CodeStix/Home-Control-GIP/Documentatie/Dossier/Fotos/IMG_4133.JPG

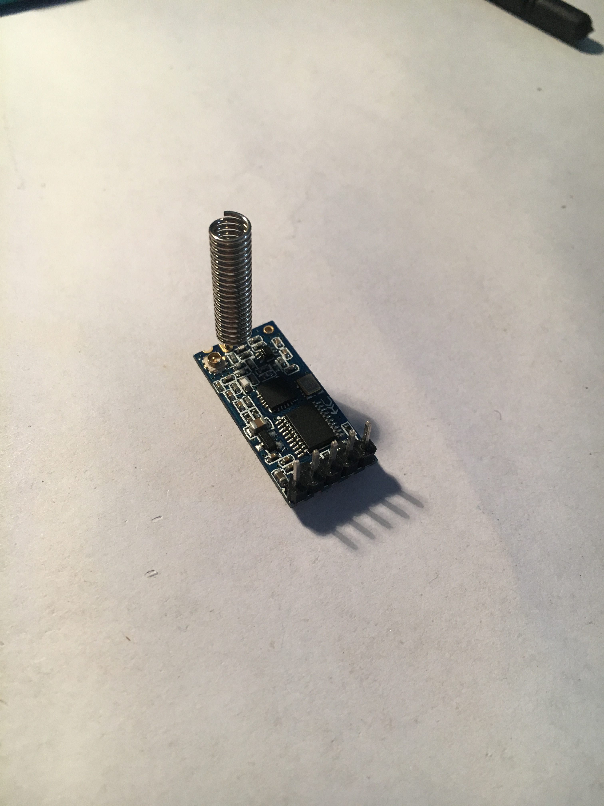
Documentatie/Dossier/Fotos/IMG_4133.JPG
