CodeStix/Home-Control-GIP/Documentatie/Dossier/Fotos/IMG_4117.JPG

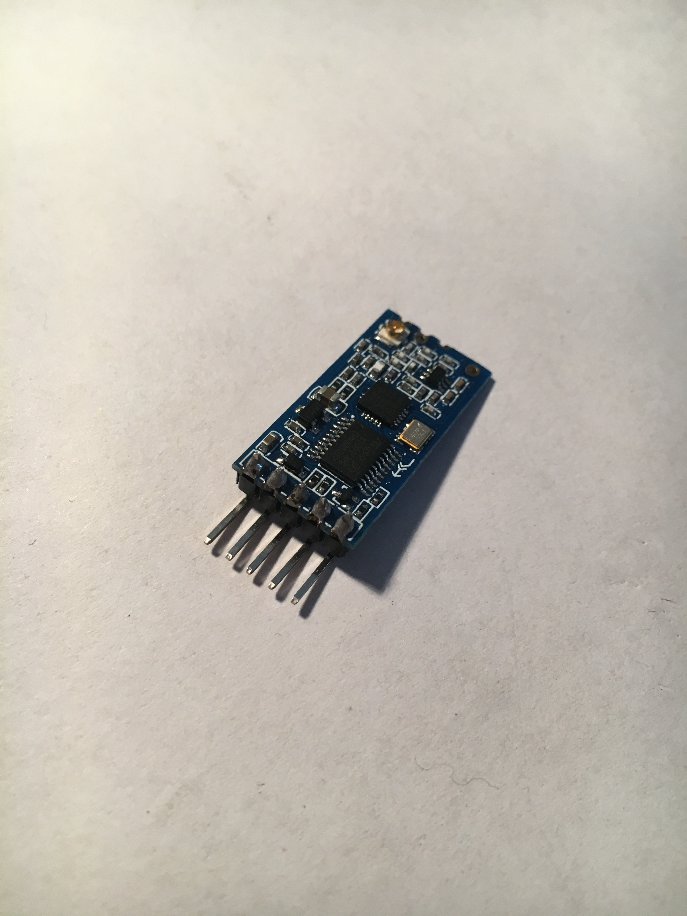
Documentatie/Dossier/Fotos/IMG_4117.JPG
