CodeStix/Home-Control-GIP/README.md

# Geïntegreerde proef: Home Control

Dit is een repo over mijn eindwerk voor de richting 6 elektriciteit-elektronica. Hier bevinden zich alle scripts, presentaties, schema's, documentaties ...

In het kort: een draadloos home-control systeem waarbij je eenvoudig en snel huishoudelijke apparaten kan aansturen via een gebruiksvriendelijke smartphone app zonder jezelf vragen te stellen over privacy.

Zie documentatie voor uitgebreide informatie.
