CodeStix/Home-Control-GIP/Slaves.rtf

## Slaves

UFID
USE
TYPE
LIVE_DATA

# Types

[0] = Aantal knoppen
[1] = Aantal drukknoppen
[2] = Aantal sliders
[2] = 3: RGB sliders
[2] = 5: RGB sliders + effect/speed slider

# 1 (5 volt module, anderen zijn 3.3 volt)

EE 0 0 0 0 0 0
Addressable ledstrip
0 0 5 0
Niks

# 2

EE 1 0 0 0 0 0
Ledstrip
0 0 3 0
Stroom

# 3

EE 2 0 0 0 0 0
Relay module 8: Disco lamp & Ventilator (want 12 volt)
8 0 0 0
Stroom? Temperatuur?

# 4

EE 3 0 0 0 0 0
Relay module 8: 2 Lampjes (want 5 volt)
8 0 0 0
Niks

# 5

EE 4 0 0 0 0 0
Led matrix
0 0 1 0
Niks

# 6

EE 5 0 0 0 0 0
