CodeStix/Home-Control-GIP/Schemas/Belasting.docx

Belasting | Bij 1 A | Bij 2 A
500 Ω | 1.44 V | 2.82 V
1k Ω | 2.75 V | 5.38 V
2k Ω | 5.47 V | 10.13 V
