CodeStix/Home-Control-GIP/Documentatie/GIP Stijn Dylan 6EE 1.pptx

## Smart Home

Stijn Rogiest & Dylan Dedapper

## Doel

- Verbeteren & versimpelen
- Universeel
- Weinig interferenties
- Goedkoop

## WAT

- makkelijk toegankelijk, snel en goed werkend systeem
- automatisatie van bvb: lichten, huishoudapparaten,verwarming…
- bediend met app of UI (user interface)

## Hardware

- "Main Control Unit" of afgekort (H-MCU)
- "Controlled Unit" of afgekort (H-CU)
- "Controlled Resource Unit" of afgekort (H-CRU)

## H-MCU

- Hoofd controller (master)
- Bestaat uit : micro controller en radio module
- stuurt naar de andere units en regelt alles

## H-CU

- Gewone controller (slave)
- Bestaat uit : micro controller en radio module
- Stuurt externe elektronica aan op bevel van de H-CMU bvb: lichten, magnetisch slot,rolluiken ...

## H-CRU

- Controller met monitoring (slave)
- Bestaat uit : micro controller en radio module
- stuurt elektronica aan die monitoring nodig heeft bvb: verwarming, ventilatie, weerstation ...

## Software

- App voor aansturing en overzicht apparaten
- Protocol genaamd HCP
- Encryptie voor beveiliging genaamd LSE

## Protocol Encryptie

- Programma dat zorgt voor communicatie tussen units

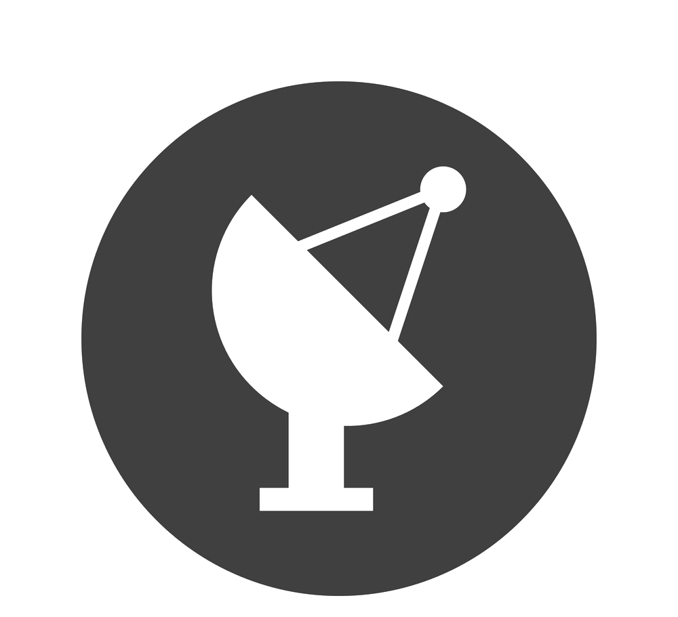
[picture p62: figure]

- Programma dat zorgt voor beveiliging en privacy

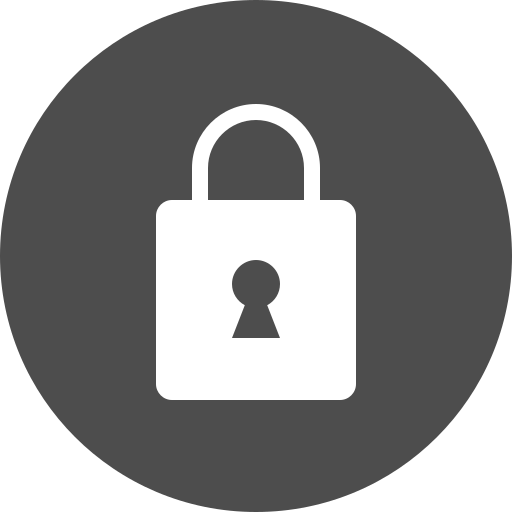
[picture p63: figure]

## Optioneel

- Protocol universaliseren
- Siri / Alexa integration
- Thuiskom-detectie(thuiskomen => lichten gaan aan)
- Automatische verwarming met tijdschema

## Slide 11

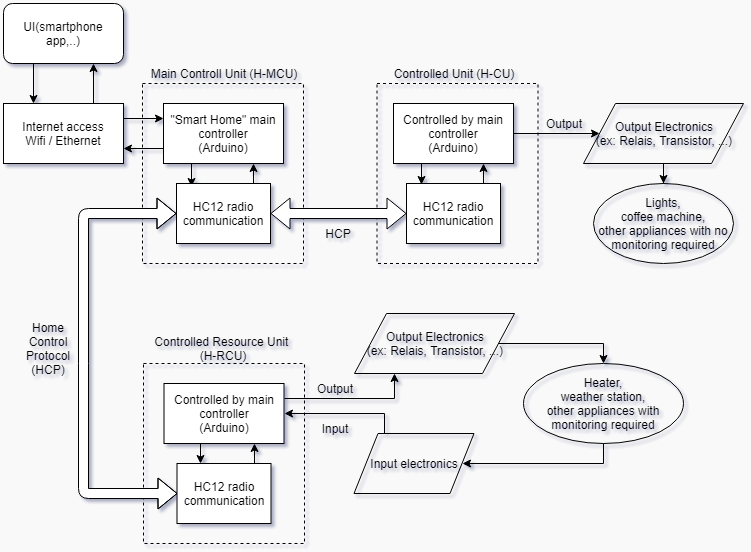
[picture p64: figure]

## EINDE
