CodeStix/Home-Control-GIP/Documentatie/GIP Stijn Dylan 6EE 2.pptx

## Smart Home Systeem

Stijn Rogiest
Dylan Dedapper

## Inleiding

Wat houd onze GIP praktisch in?

## 1.1 Onderwerp

Ons onderwerp in tien woorden samengevat.

“Goedkoop en zelfstandig het huis automatiseren via verschillende voorgeprogrammeerde modules.”

## 1.2 De Planning

Wat moet er nog gebeuren?

- App maken
- Voor behuizing zorgen
- Schema afmaken
- PCBs laten maken?

## 1.3 Milestones

- Goed functionerende antennes
  - Stabiele seriële communicatie
- Hardware
  - PCB
    - Master
    - Slave
- Software
  - Mobiele app
    - Communicatie naar master via HTTP
  - Protocol integreren in master & slave.
- Het Protocol (HCP)
  - Beveiligen
    - LSE
  - Feedback realiseren
  - Failover
    - Resending
    - Data loss

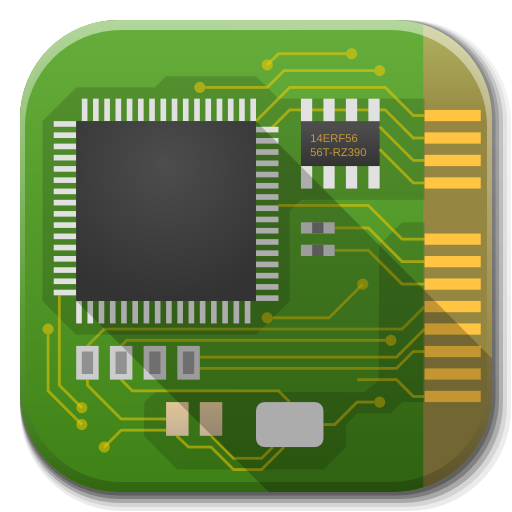
[picture p65: figure]

## 2. Realisaties

Wat is er gerealiseerd en wat moet er nog gerealiseerd worden?

## Slide 7

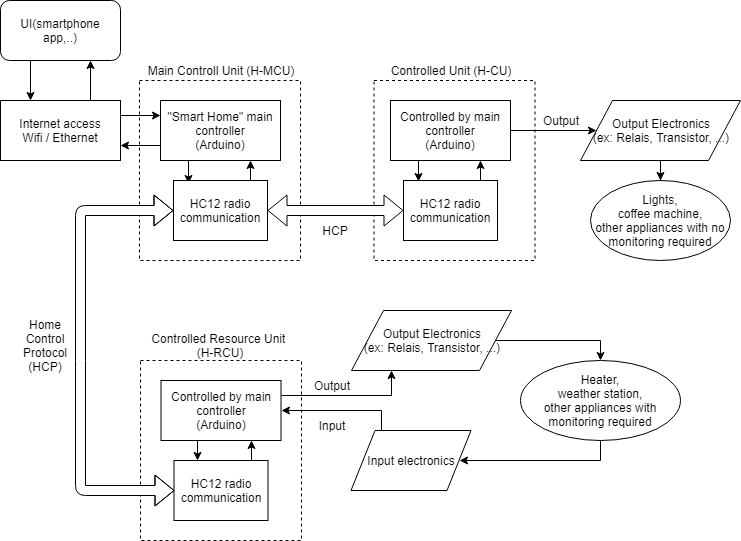
[picture p66: figure]

Notes: Tot nu toe...

## 2.1.1 Hardware

- Werking binnen het geheel.
  - Ons idee is omgezet in realiteit.
- De interactie met de software.
  - Commando’s versturen via seriële monitor.
- Draadloze communicatie
  - Zender
  - Ontvanger

Wat werk?
Wat werkt niet? En waarom?
Oplossingen?
Verbeteringen?

## Slide 9

Master

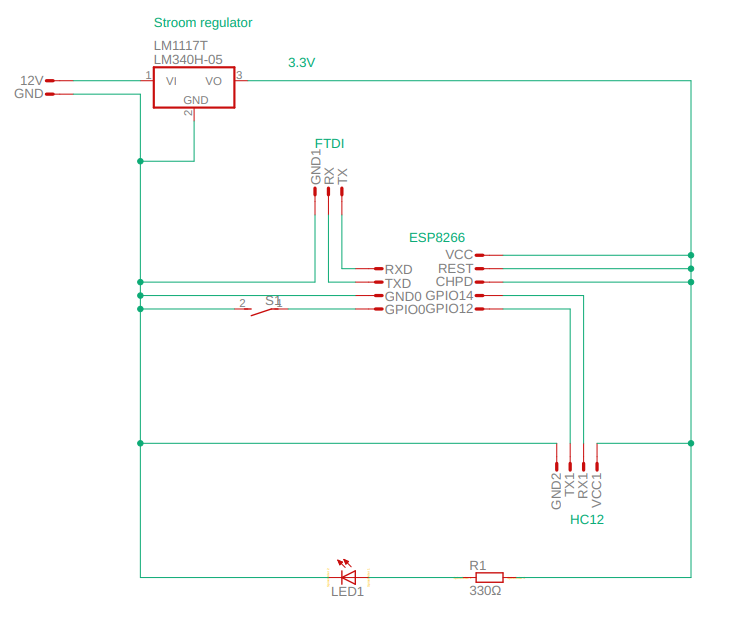
[picture p67: figure]

## Slide 10

Slave

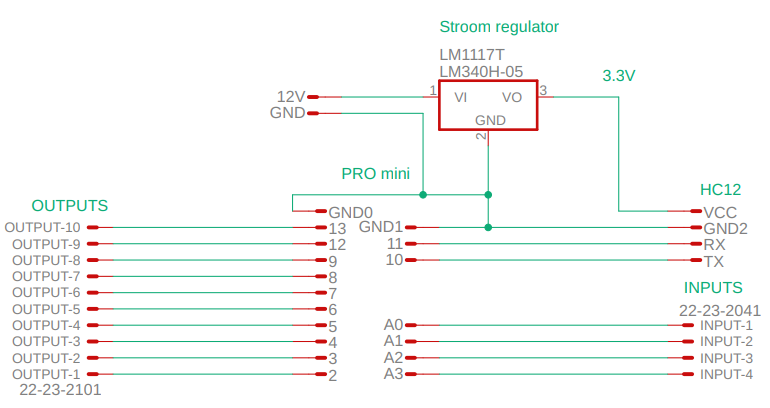
[picture p68: figure]

## 2.1.2 Software

- Een gepersonaliseerde C++ library
  - Protocol (HCP)
  - Realiseert het verstuur en ontvang gebeurden.
- Software is gemaakt
  - Gebruik gemaakt van de Arduino omgeving.
  - Library gemaakt met Visual Code
- Debuggen
  - Gebruik maken van seriële monitor.
    - Draadloze communicatie gebeurt via SoftwareSerial.

Wat werk?
Wat werkt niet? En waarom?
Oplossingen?
Verbeteringen?

## 2.1.2.1 Draadloze communicatie

Uitleg van het Protocol

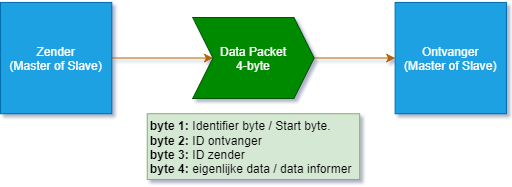
[picture p69: figure]

## Slide 13

## Slide 14

## Slide 15

## Slide 16

## Slide 17

## Slide 18

## Slide 19

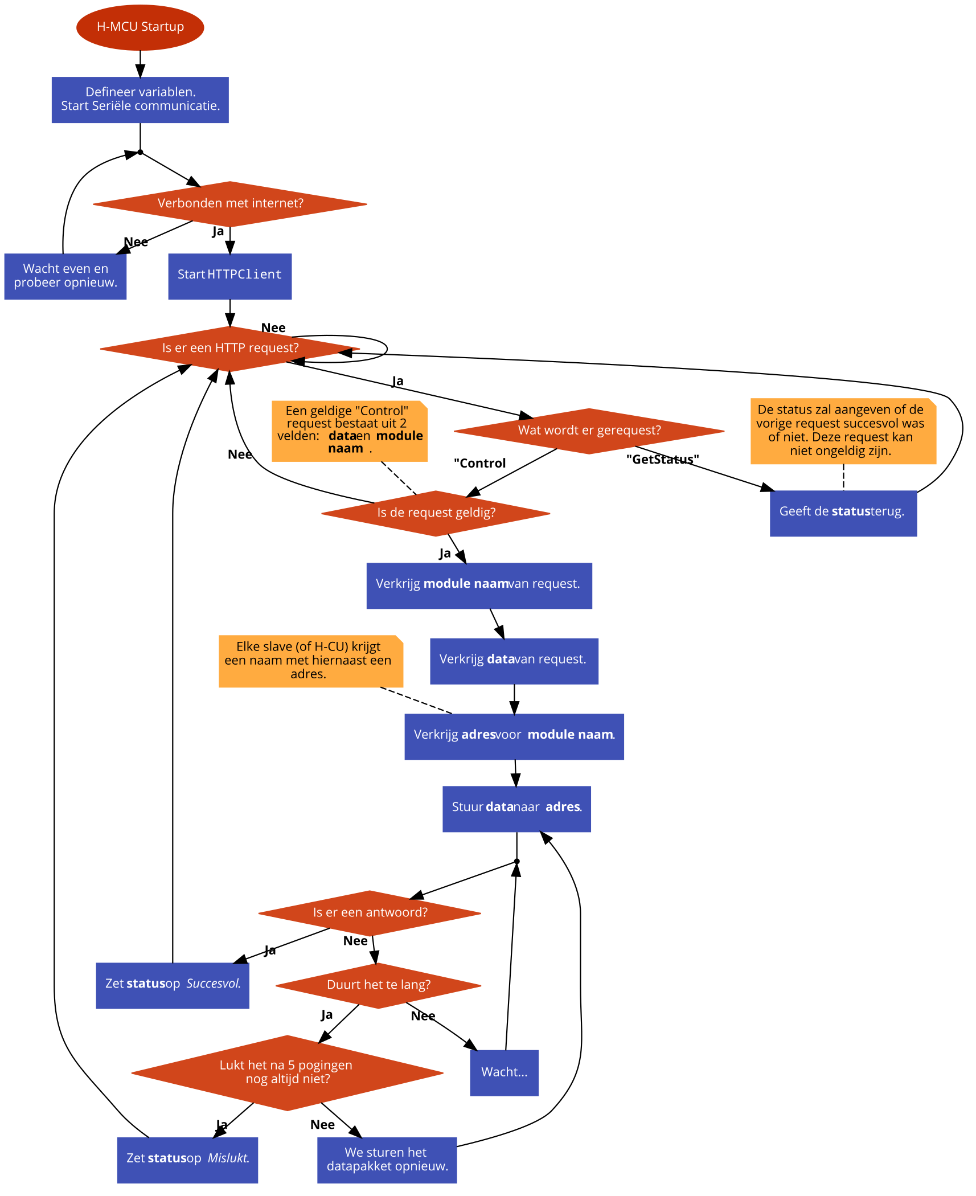
[picture p70: figure]

## Slide 20

## Slide 21

## 2.2 Wat moet er nog gerealiseerd worden?

## 2.2.1 Hardware

- Modules afwerken
  - Behuizing
  - PCB ontwerpen
  - Deftige antenne
  - Stroomdetectie

## 2.2.2 Software

- Beveiliging
  - LSE
    - Low Size Encryption
    - Op basis van 4 bytes, zie protocol.
- Stroomdetectie
  - Omvormen van waardes
- App
  - Software: Xamarin
- Gegevens naar het web
  - Versturen
  - Ontvangen

## 2.2.2.1 Alternativen

- Voor software
  - App maken via mit-builder
  - Geen LSE
- Voor hardware:
  - Spiraal antenne gebruiken
  - Geen zelfgemaakt PCB naar breadboard

## 3. Conclusies

Wat hebben we geleerd en
wat gaan we nu doen

## 3.1 Wat hebben we geleerd?

- Gebruiken van verschillende micro controllers.
- Extra aandacht geven aan goed verbinden van kabels en storing te vermijden.
- Manueel uploaden naar een micro controllers .
- Leren gebruik maken van draadloze communicatie tussen microcontrollers

## 3.2. Wat nu verder?

- Draadloze communicatie verbeteren.
- Programma optimaliseren.
- Prototype uitwerken.
- App maken.

## EINDE
