CodeStix/Home-Control-GIP/Documentatie/Logboeken/Weken/Logboek Week 22.docx

# Logboek

## Geïntegreerde Proef

Klas : 6EE

2018-2019

### Technisch adviseur coördinator : M. Van Gucht

Mentor(en) school : E. Arckens

Leerling : Stijn Rogiest

# Logboek

## Geïntegreerde Proef

Week 22

2018-2019

Naam : Home Control; H-C

Omschrijving opdracht G.I.P:

Home control systeem, een slim huis.

Betrokken leerkrachten Vak

Mr. E. Arckens Elektriciteit-elektronica

Coppejans Stijn

Schoolweek : 22

Datum | Vak | Omschrijving van de studie, taak of voorbereiding
27/05/2019 | EE | Bespreken met Dylan over het demo-huis: in dit huis zullen onze modules worden voorgesteld aan het publiek.
28/05/2019 | EE | Kritisch Thunkable probleem wegens hernamen van variabel, zo snel mogelijk een oplossing proberen vinden...
30/05/2019 | Thuis | Hermaken van de app. onoplosbaar probleem door het Thunkable platform.
31/05/2019 | Thuis | Hermaken van de app…
