CodeStix/Home-Control-GIP/App/AchtergrondKabel14.png

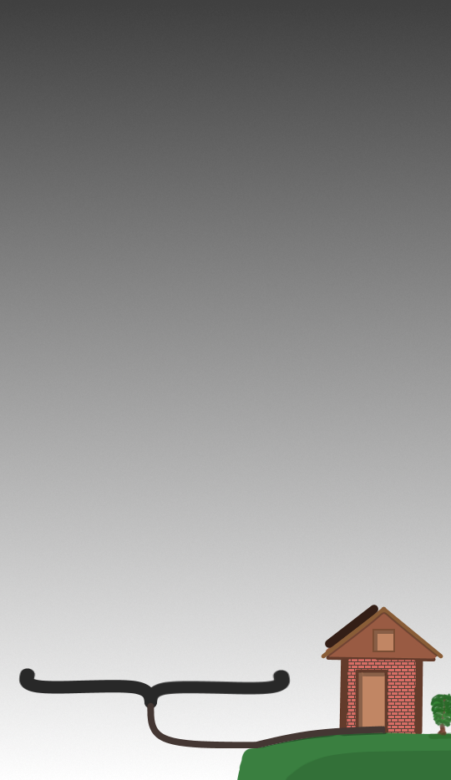
App/AchtergrondKabel14.png
