CodeStix/Home-Control-GIP/App/AchtergrondKabelWifi13.png

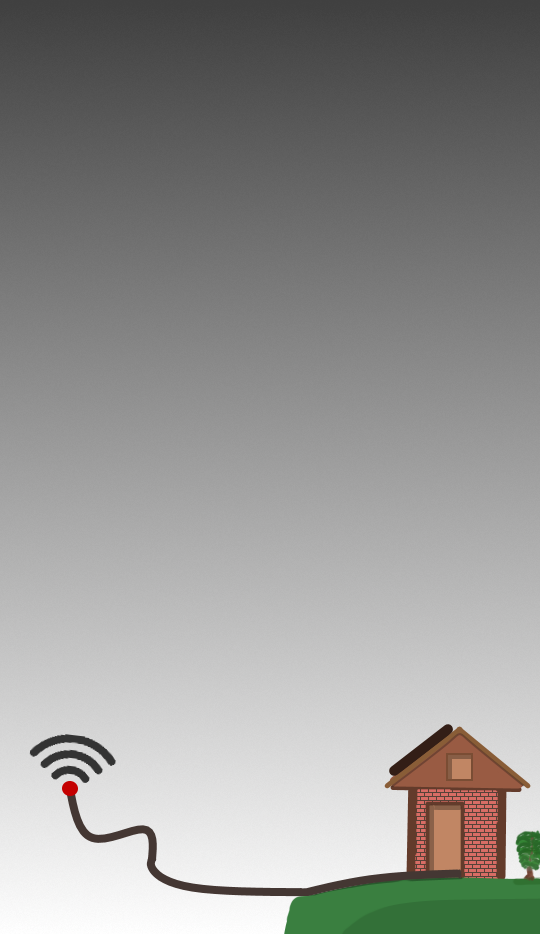
App/AchtergrondKabelWifi13.png
