CodeStix/Home-Control-GIP/App/Screenshots/Bind master.PNG

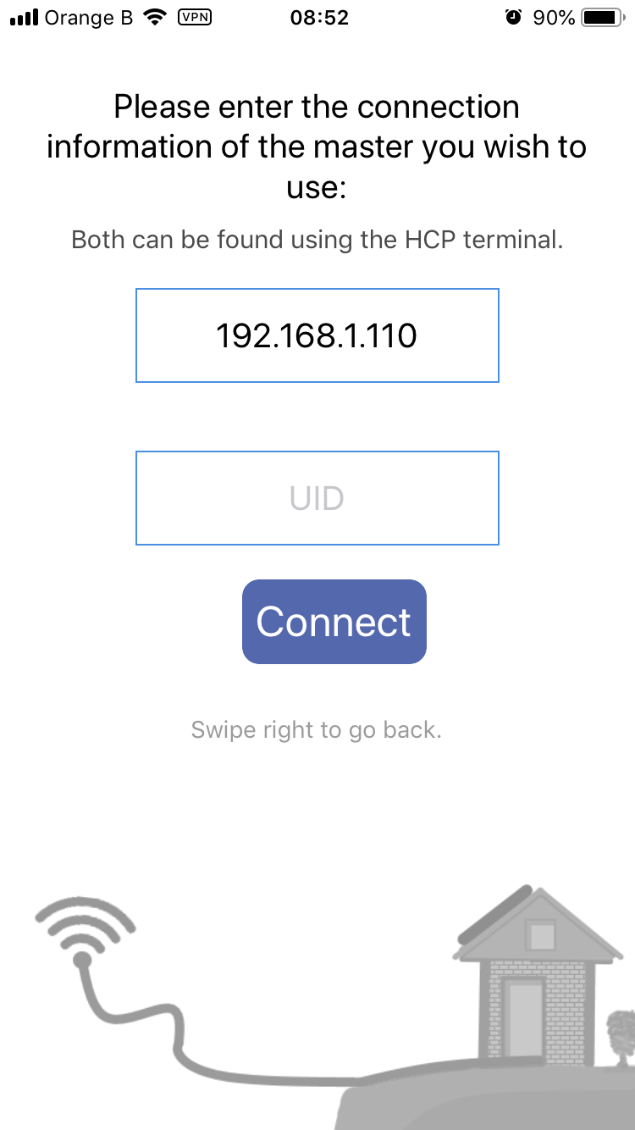
App/Screenshots/Bind master.PNG
