CodeStix/Home-Control-GIP/App/Screenshots/Configure.PNG

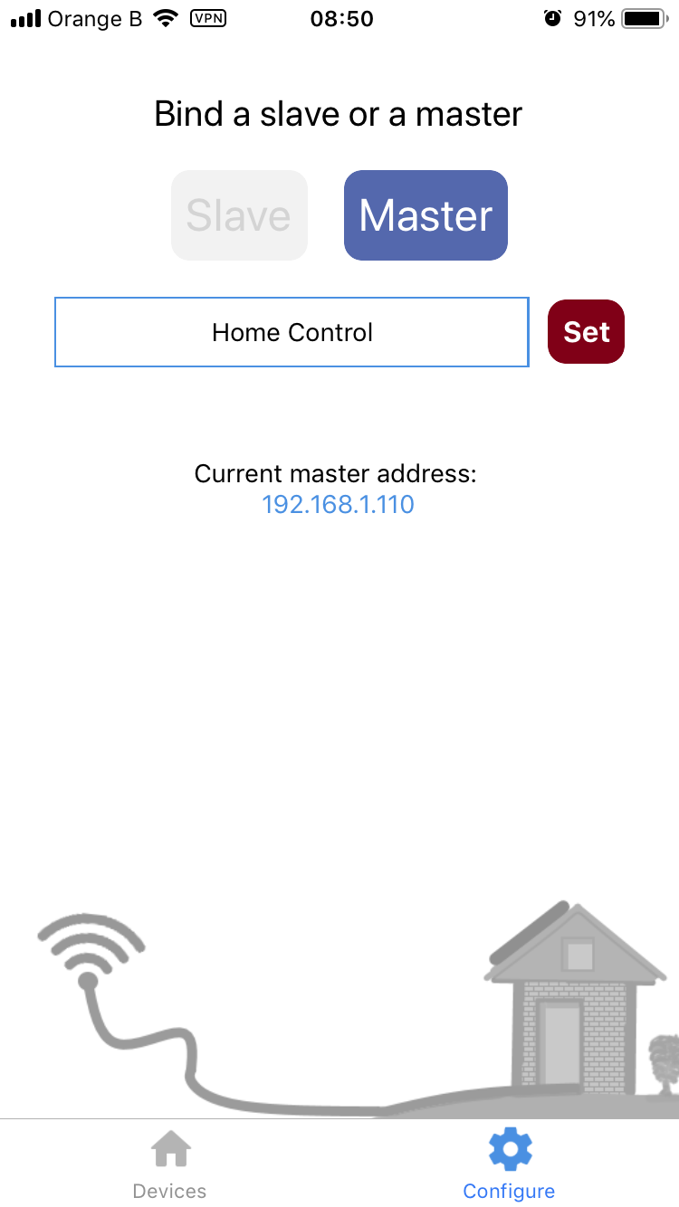
App/Screenshots/Configure.PNG
