CodeStix/Home-Control-GIP/App/Screenshots/Connection Check.PNG

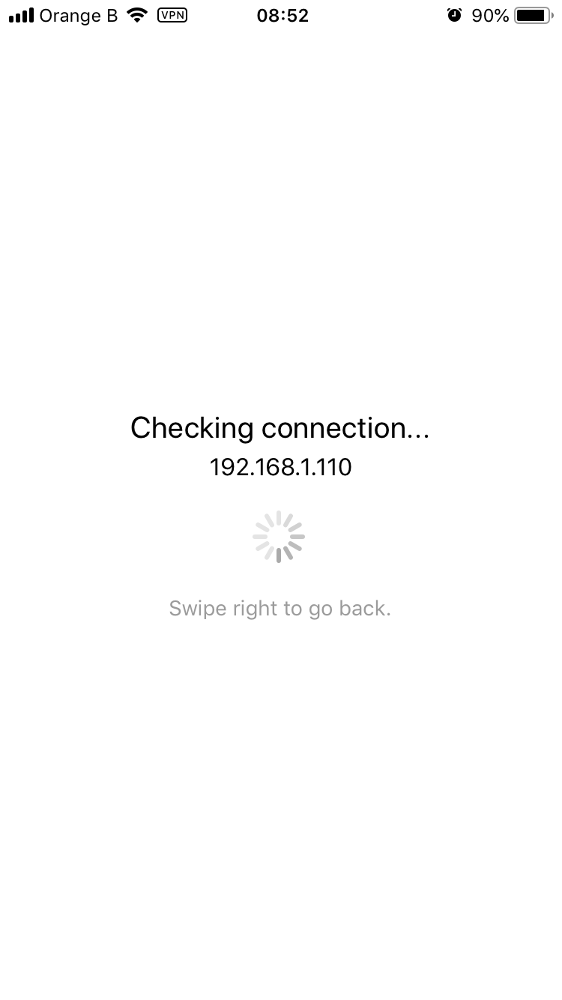
App/Screenshots/Connection Check.PNG
