CodeStix/Home-Control-GIP/App/Screenshots/Connection Fail.PNG

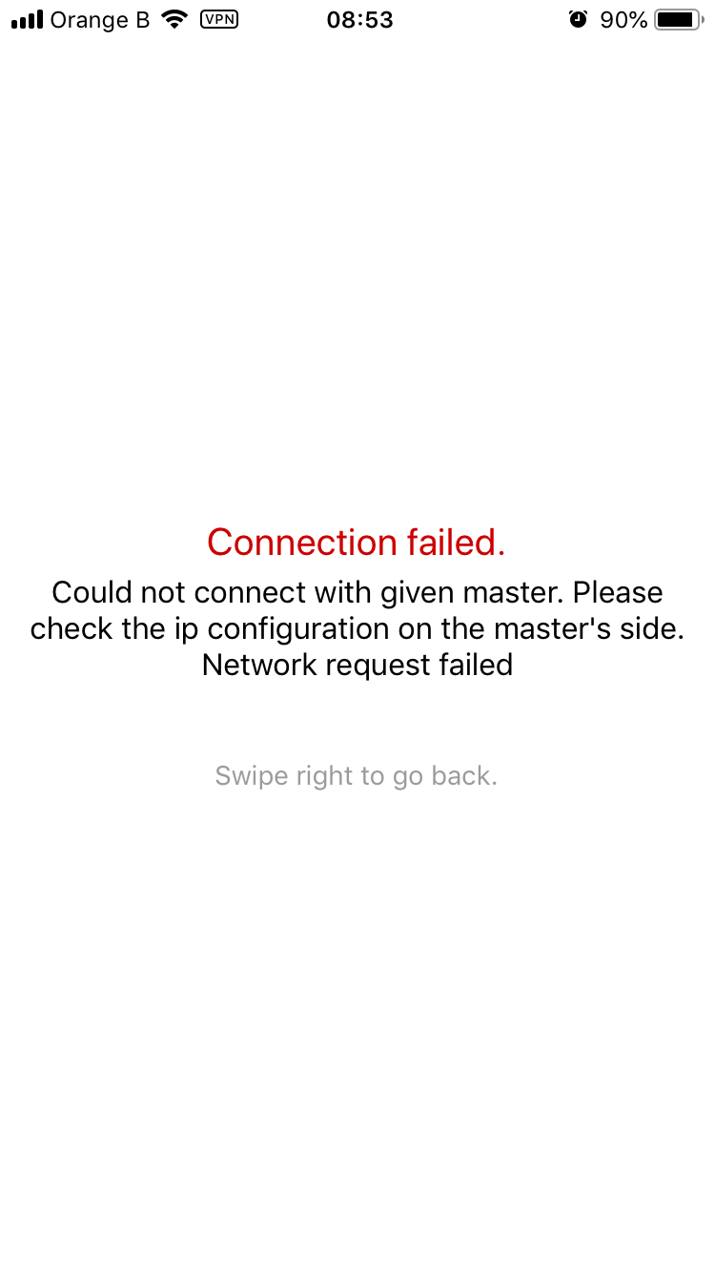
App/Screenshots/Connection Fail.PNG
