CodeStix/Home-Control-GIP/App/Screenshots/Device 2.PNG

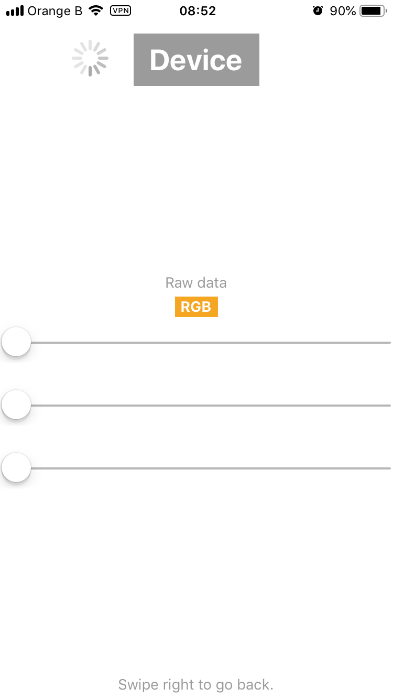
App/Screenshots/Device 2.PNG
