CodeStix/Home-Control-GIP/App/Screenshots/Device List.PNG

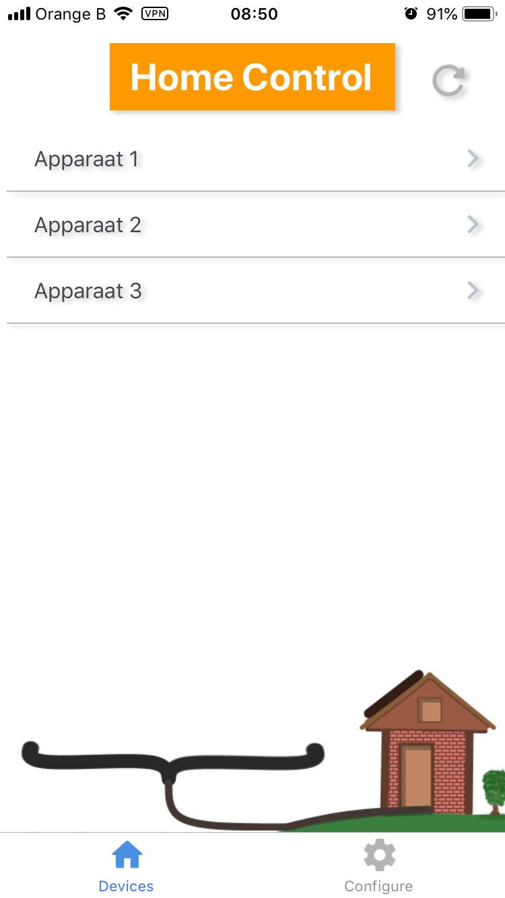
App/Screenshots/Device List.PNG
