CodeStix/Home-Control-GIP/App/Screenshots/Device.PNG

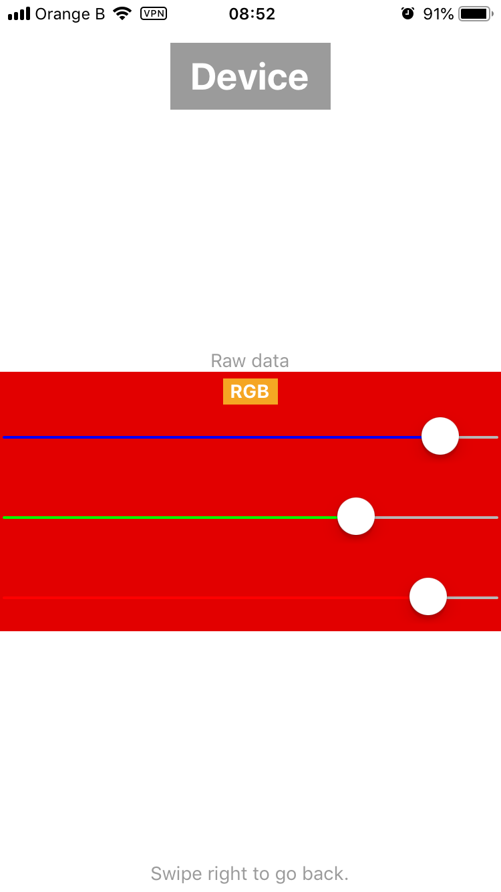
App/Screenshots/Device.PNG
