CodeStix/Home-Control-GIP/App/Screenshots/Startup.PNG

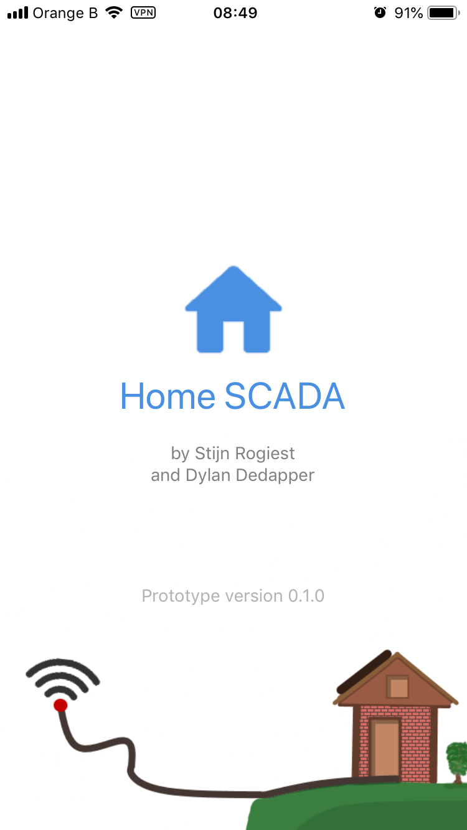
App/Screenshots/Startup.PNG
