CodeStix/Home-Control-GIP/Documentatie/Dossier/circuit ledstrip.png

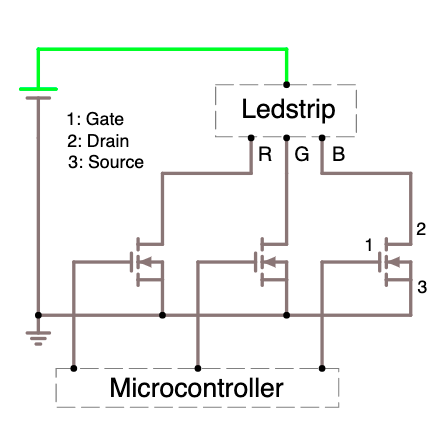
Documentatie/Dossier/circuit ledstrip.png
