CodeStix/Home-Control-GIP/Documentatie/Dossier/diagram eeprom master.png

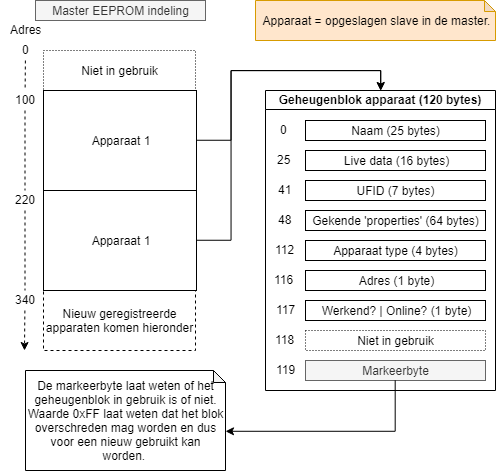
Documentatie/Dossier/diagram eeprom master.png
