CodeStix/Home-Control-GIP/Documentatie/Dossier/diagram eeprom slave.png

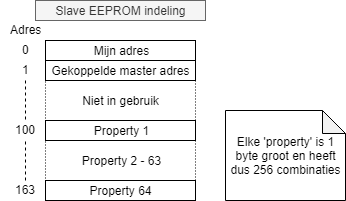
Documentatie/Dossier/diagram eeprom slave.png
