CodeStix/Home-Control-GIP/Documentatie/Dossier/Flowchart HCP_CU/Flowchart HCP_CU.png

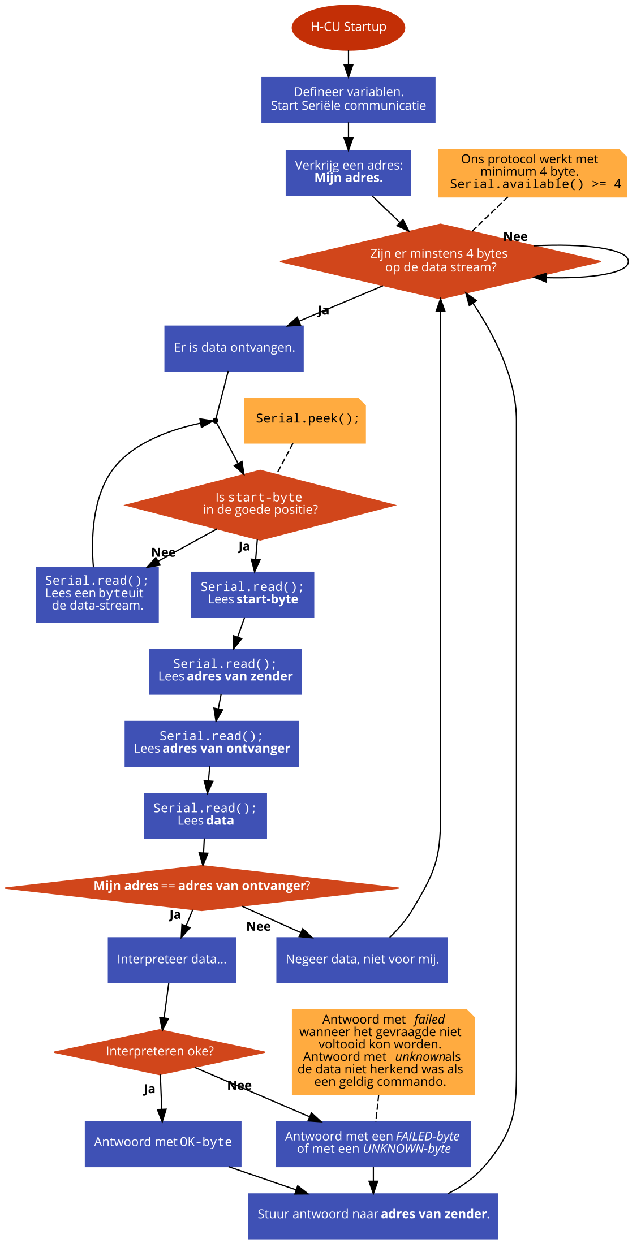
Documentatie/Dossier/Flowchart HCP_CU/Flowchart HCP_CU.png
