CodeStix/Home-Control-GIP/Documentatie/Dossier/Flowchart HCP_MCU/Flowchart HCP_MCU versie 4.png

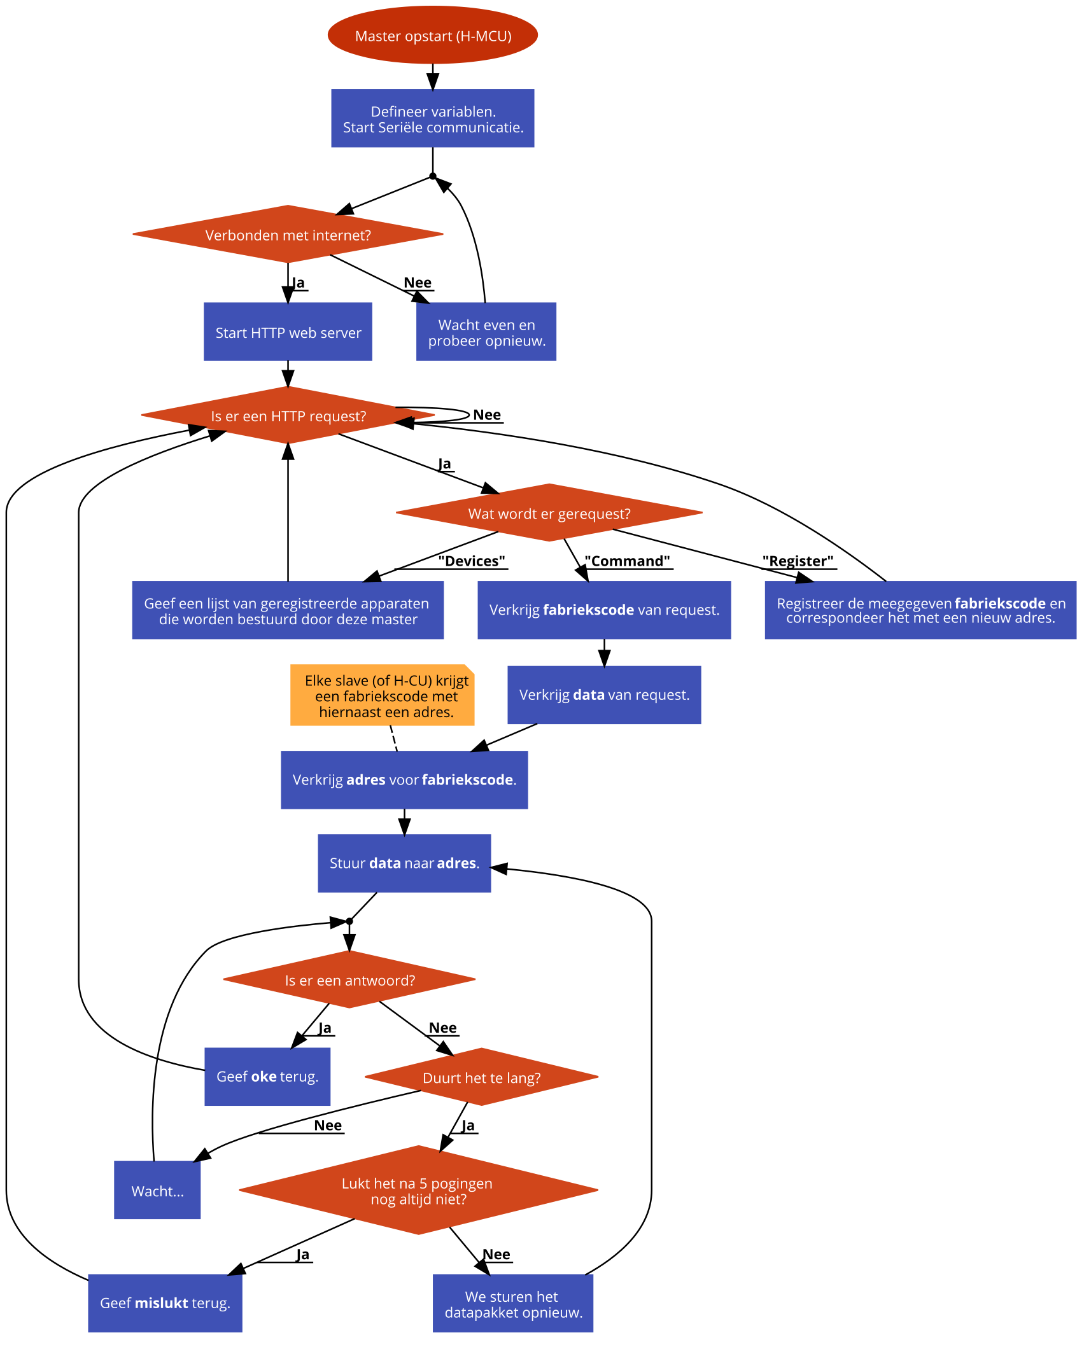
Documentatie/Dossier/Flowchart HCP_MCU/Flowchart HCP_MCU versie 4.png
