CodeStix/Home-Control-GIP/Documentatie/Dossier/Fotos/Andere/IMG_3954.JPG

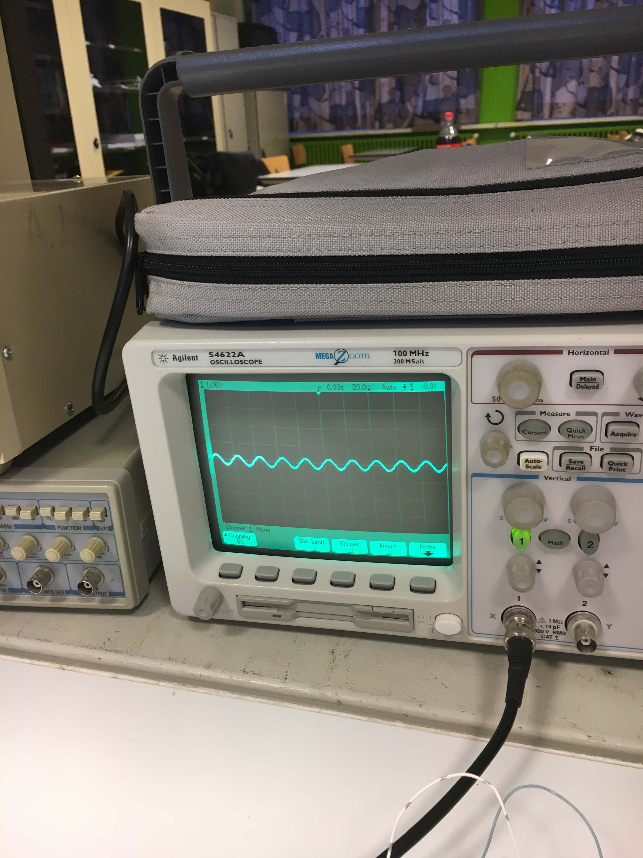
Documentatie/Dossier/Fotos/Andere/IMG_3954.JPG
