CodeStix/Home-Control-GIP/Documentatie/Dossier/Fotos/Andere/IMG_3955.JPG

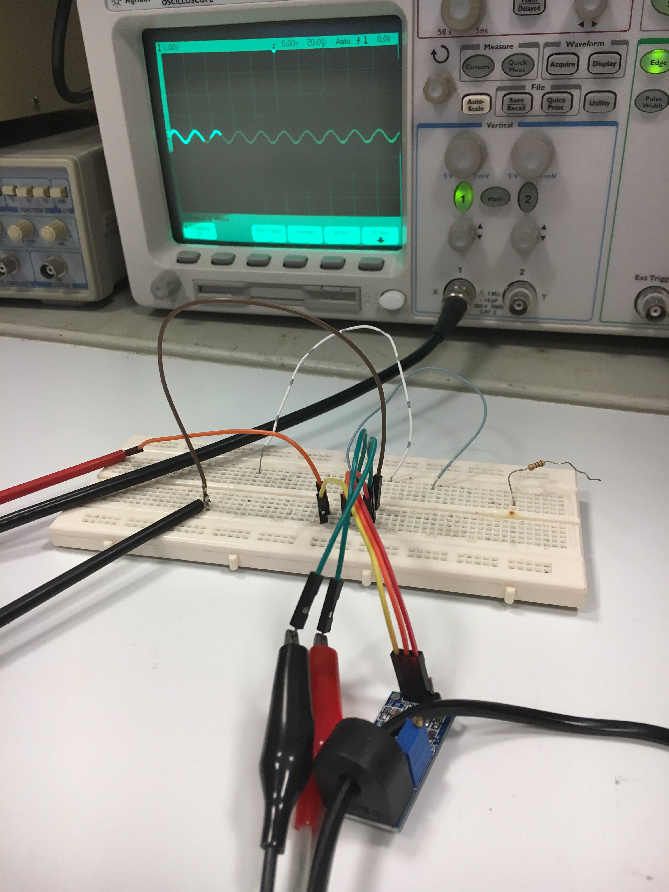
Documentatie/Dossier/Fotos/Andere/IMG_3955.JPG
