CodeStix/Home-Control-GIP/Documentatie/Dossier/Fotos/IMG_4105.JPG

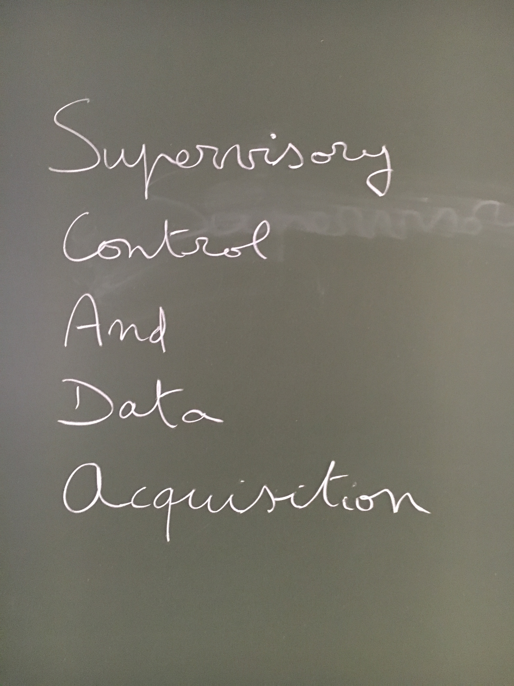
Documentatie/Dossier/Fotos/IMG_4105.JPG
