CodeStix/Home-Control-GIP/Documentatie/Dossier/Fotos/IMG_4108.JPG

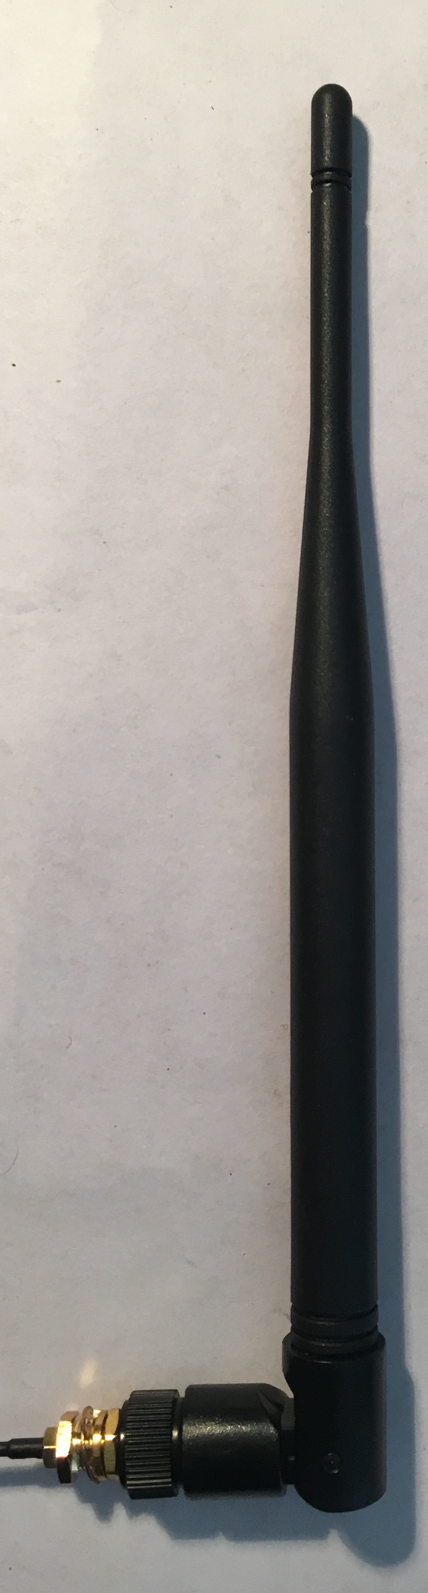
Documentatie/Dossier/Fotos/IMG_4108.JPG
