CodeStix/Home-Control-GIP/Documentatie/Dossier/Fotos/IMG_4113.JPG

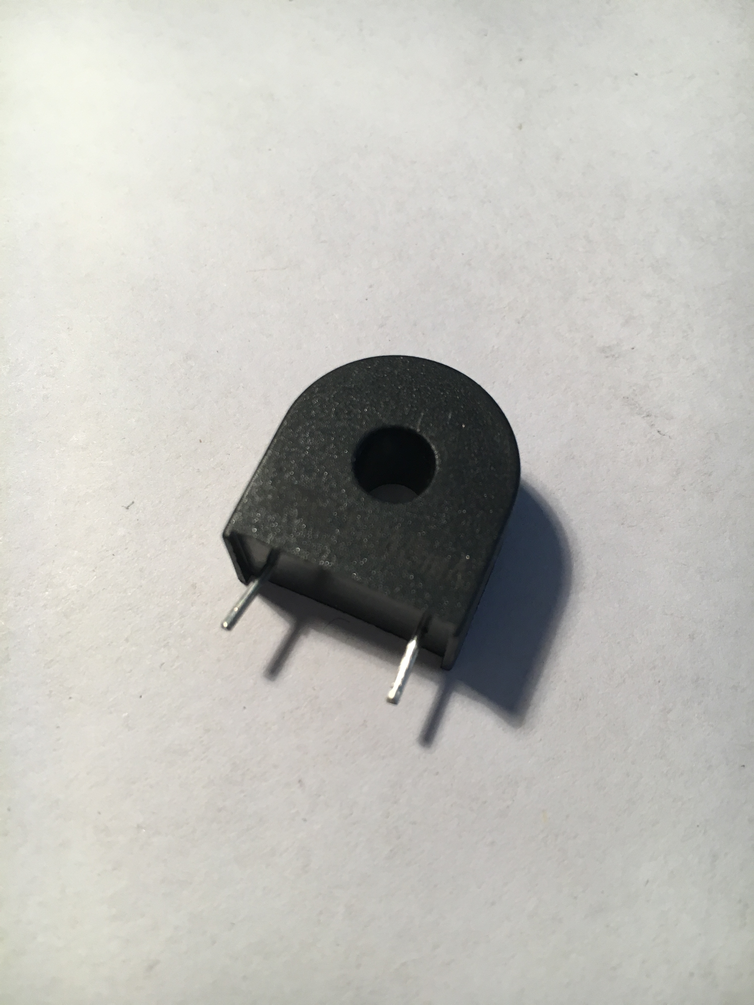
Documentatie/Dossier/Fotos/IMG_4113.JPG
