CodeStix/Home-Control-GIP/Documentatie/Dossier/Fotos/IMG_4114.JPG

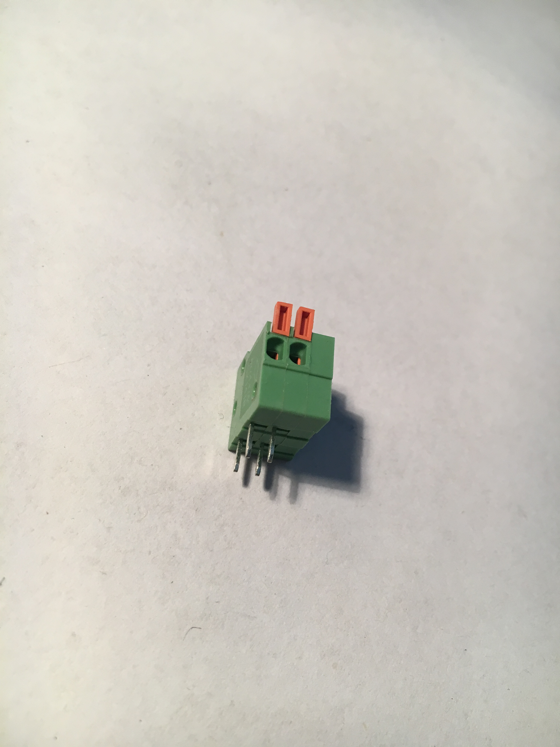
Documentatie/Dossier/Fotos/IMG_4114.JPG
