CodeStix/Home-Control-GIP/Documentatie/Dossier/Fotos/IMG_4115.JPG

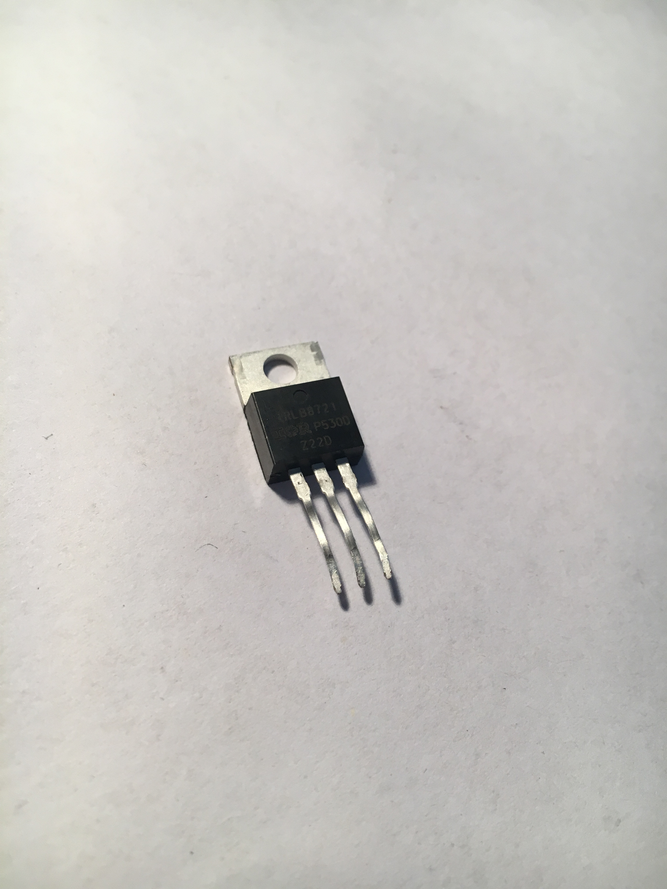
Documentatie/Dossier/Fotos/IMG_4115.JPG
