CodeStix/Home-Control-GIP/Documentatie/Dossier/Fotos/IMG_4116.JPG

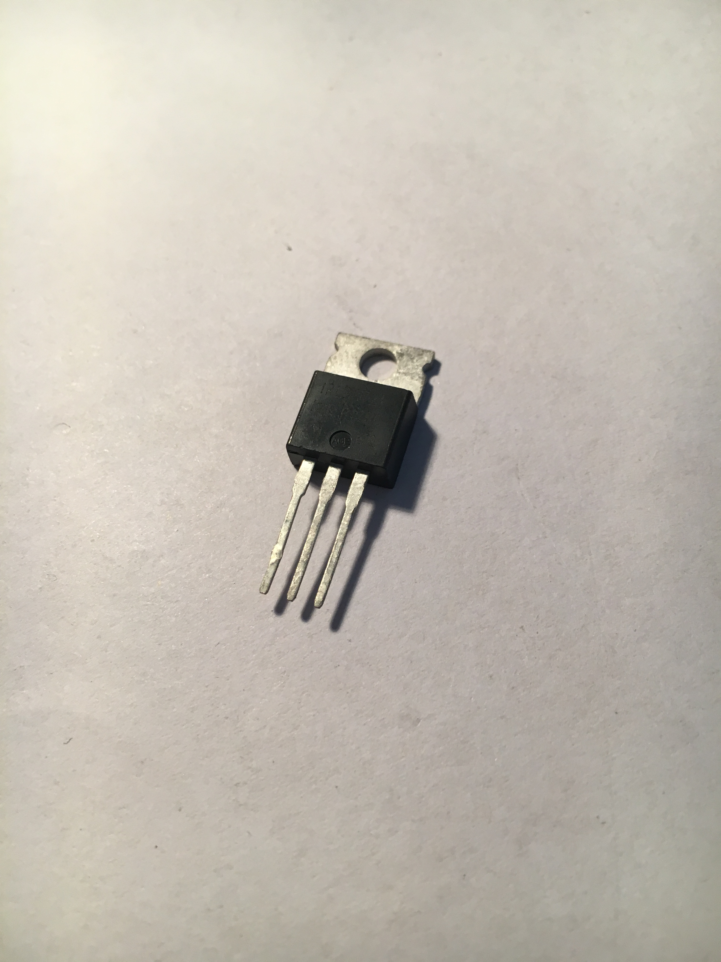
Documentatie/Dossier/Fotos/IMG_4116.JPG
