CodeStix/Home-Control-GIP/Documentatie/Dossier/Fotos/IMG_4118.JPG

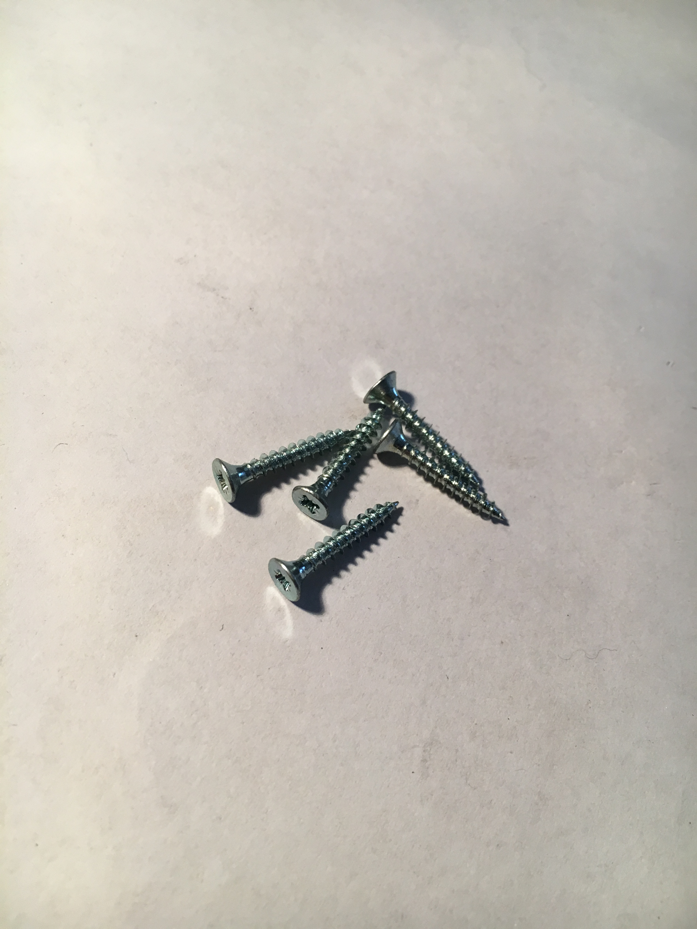
Documentatie/Dossier/Fotos/IMG_4118.JPG
