CodeStix/Home-Control-GIP/Documentatie/Dossier/Fotos/IMG_4119.JPG

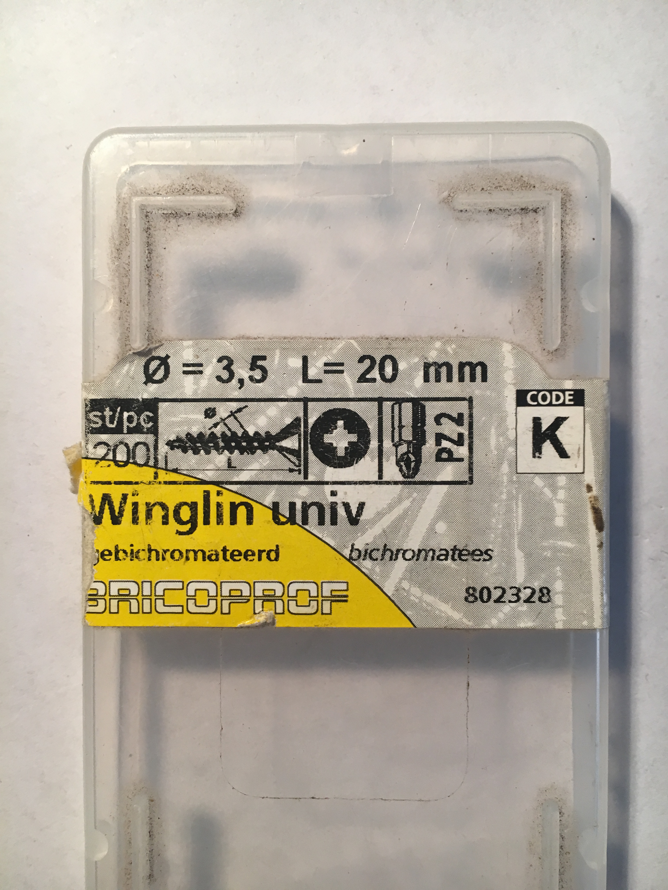
Documentatie/Dossier/Fotos/IMG_4119.JPG
