CodeStix/Home-Control-GIP/Documentatie/Dossier/Fotos/IMG_4120.JPG

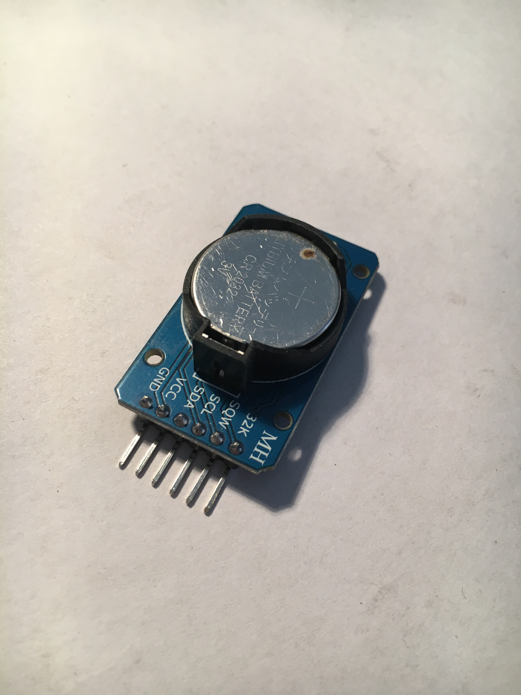
Documentatie/Dossier/Fotos/IMG_4120.JPG
