CodeStix/Home-Control-GIP/Documentatie/Dossier/Fotos/IMG_4121.JPG

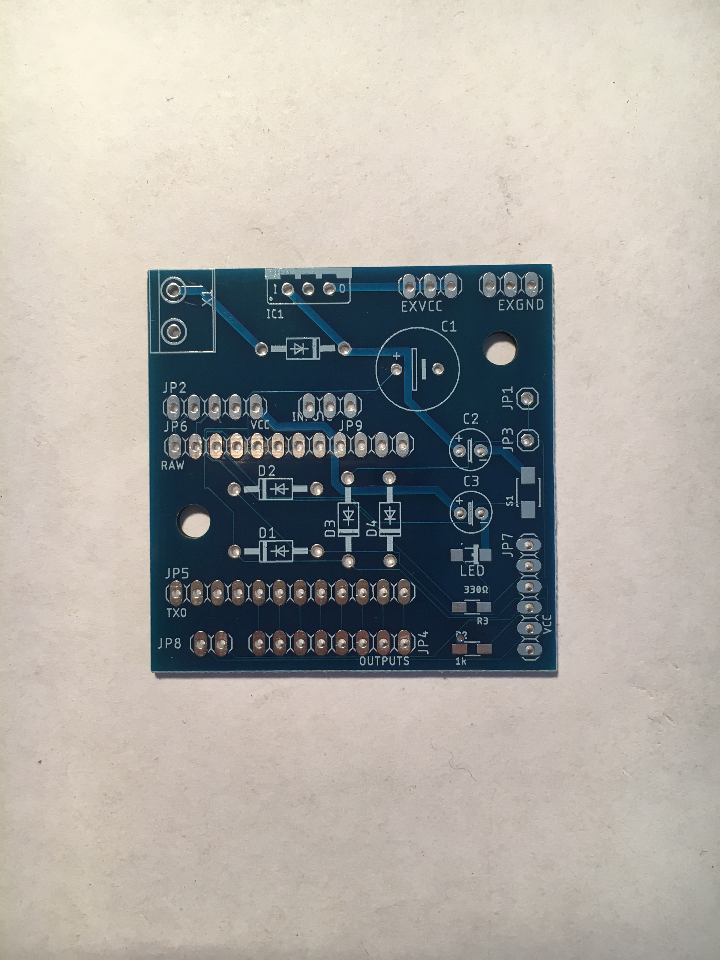
Documentatie/Dossier/Fotos/IMG_4121.JPG
