CodeStix/Home-Control-GIP/Documentatie/Dossier/Fotos/IMG_4122.JPG

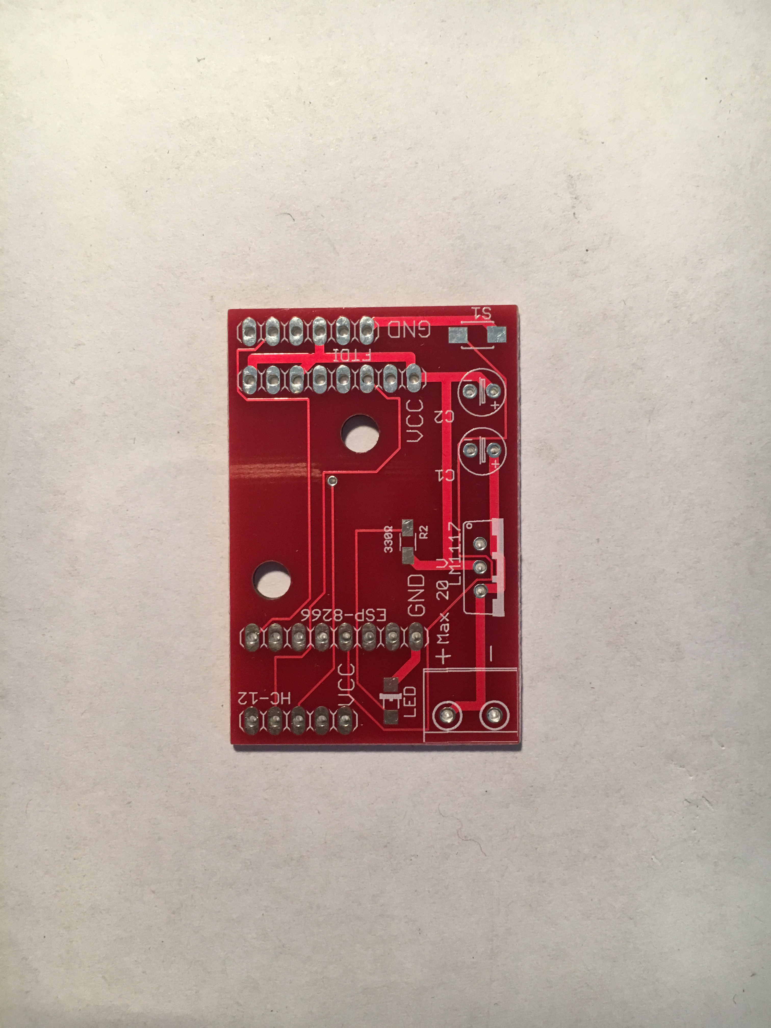
Documentatie/Dossier/Fotos/IMG_4122.JPG
