CodeStix/Home-Control-GIP/Documentatie/Dossier/Fotos/IMG_4123.JPG

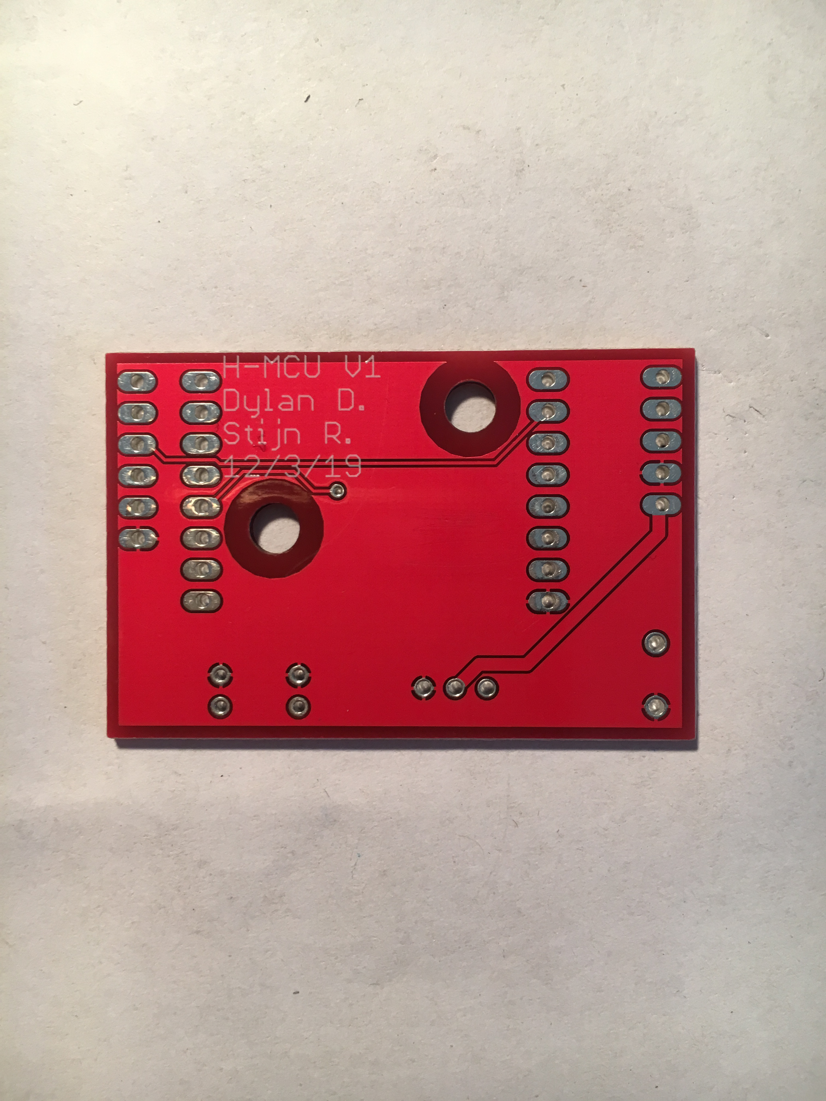
Documentatie/Dossier/Fotos/IMG_4123.JPG
