CodeStix/Home-Control-GIP/Documentatie/Dossier/Fotos/IMG_4124.JPG

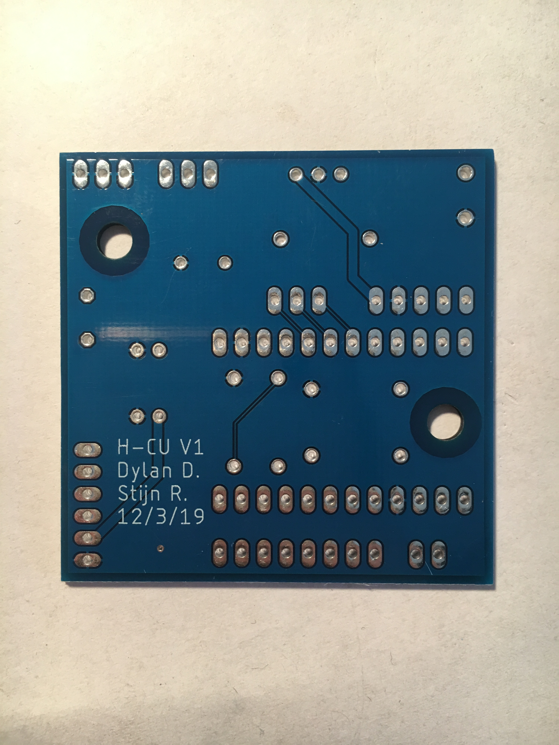
Documentatie/Dossier/Fotos/IMG_4124.JPG
