CodeStix/Home-Control-GIP/Documentatie/Dossier/Fotos/IMG_4125.JPG

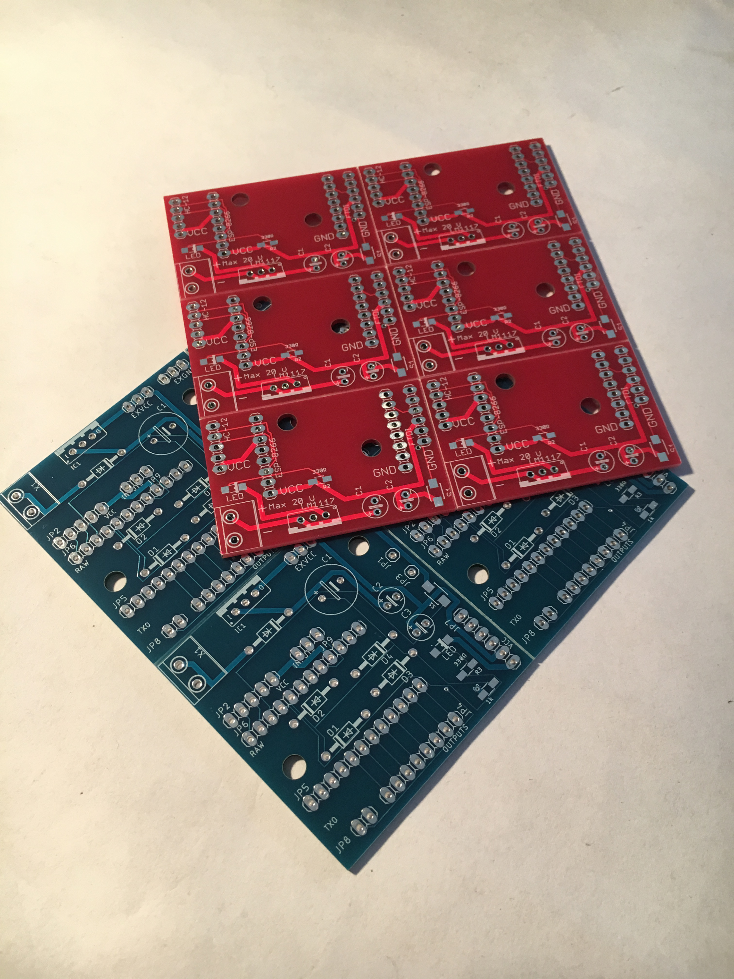
Documentatie/Dossier/Fotos/IMG_4125.JPG
