CodeStix/Home-Control-GIP/Documentatie/Dossier/Fotos/IMG_4126.JPG

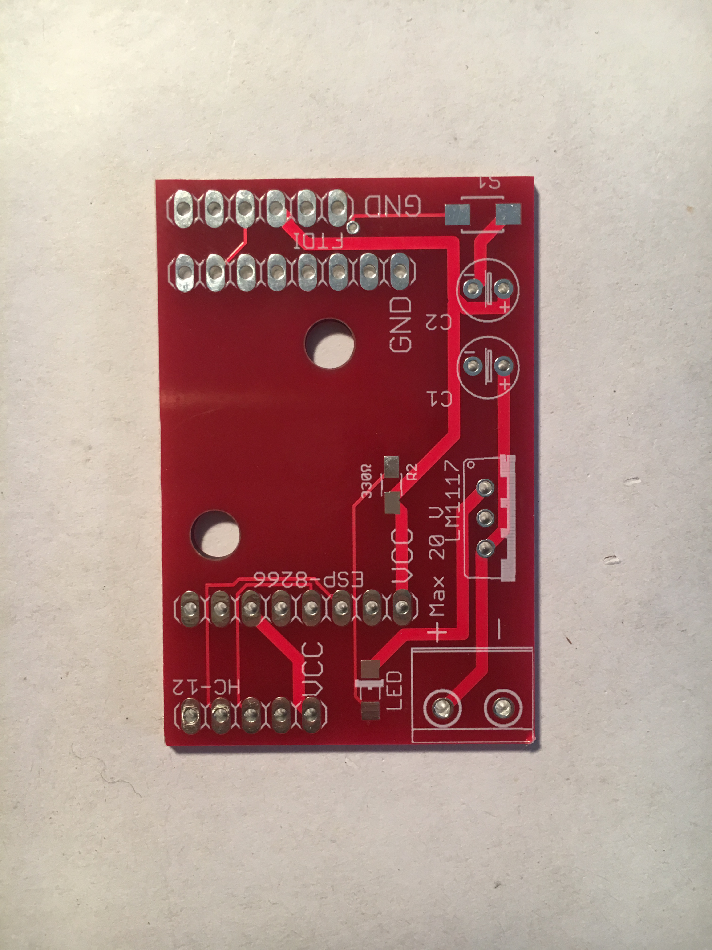
Documentatie/Dossier/Fotos/IMG_4126.JPG
