CodeStix/Home-Control-GIP/Documentatie/Dossier/Fotos/IMG_4127.JPG

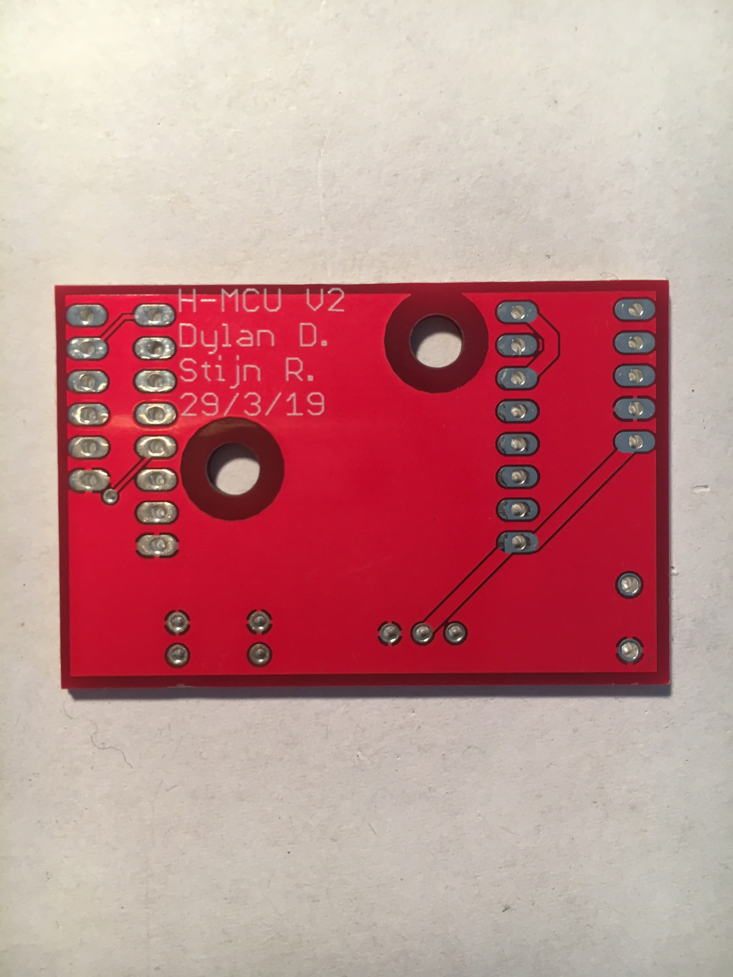
Documentatie/Dossier/Fotos/IMG_4127.JPG
