CodeStix/Home-Control-GIP/Documentatie/Dossier/Fotos/IMG_4128.JPG

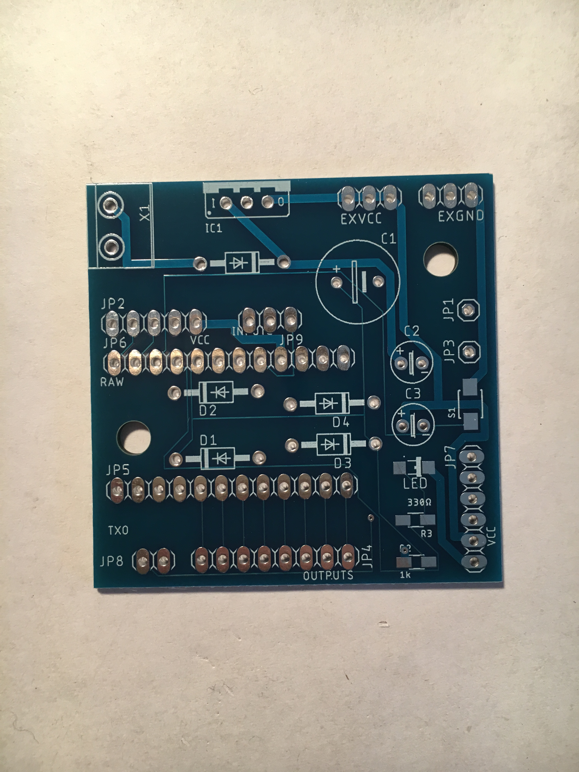
Documentatie/Dossier/Fotos/IMG_4128.JPG
