CodeStix/Home-Control-GIP/Documentatie/Dossier/Fotos/IMG_4129.JPG

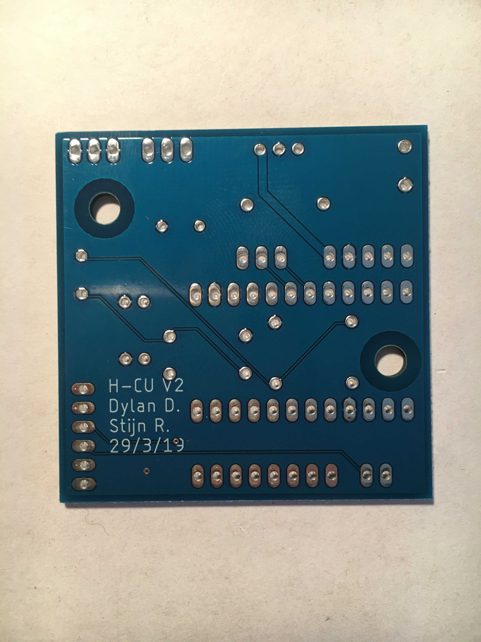
Documentatie/Dossier/Fotos/IMG_4129.JPG
