CodeStix/Home-Control-GIP/Documentatie/Dossier/Fotos/IMG_4130.JPG

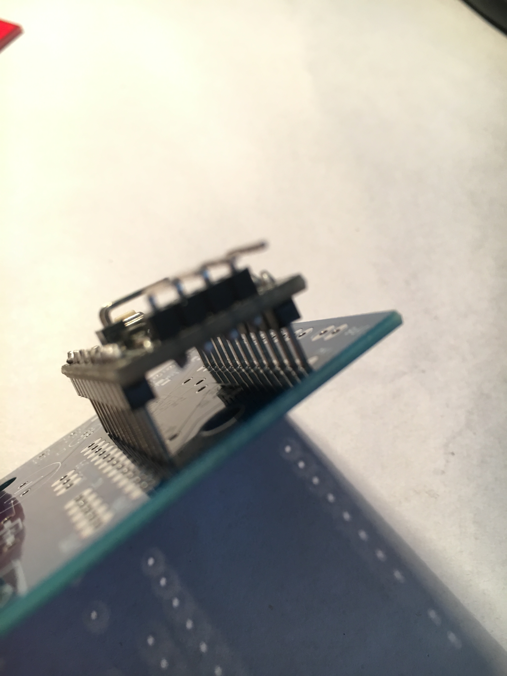
Documentatie/Dossier/Fotos/IMG_4130.JPG
