CodeStix/Home-Control-GIP/Documentatie/Dossier/Fotos/IMG_4131.JPG

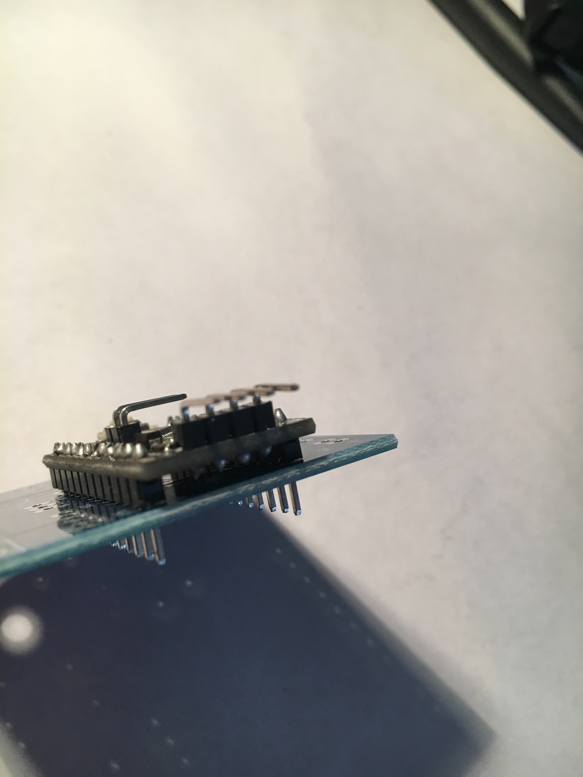
Documentatie/Dossier/Fotos/IMG_4131.JPG
