CodeStix/Home-Control-GIP/Documentatie/Dossier/Fotos/IMG_4132.JPG

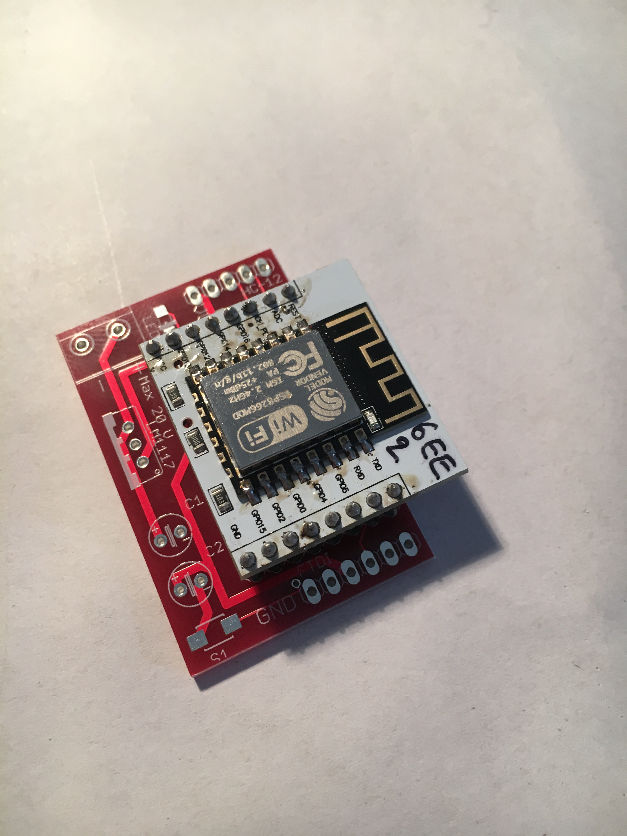
Documentatie/Dossier/Fotos/IMG_4132.JPG
