CodeStix/Home-Control-GIP/Documentatie/Dossier/Fotos/IMG_4137.JPG

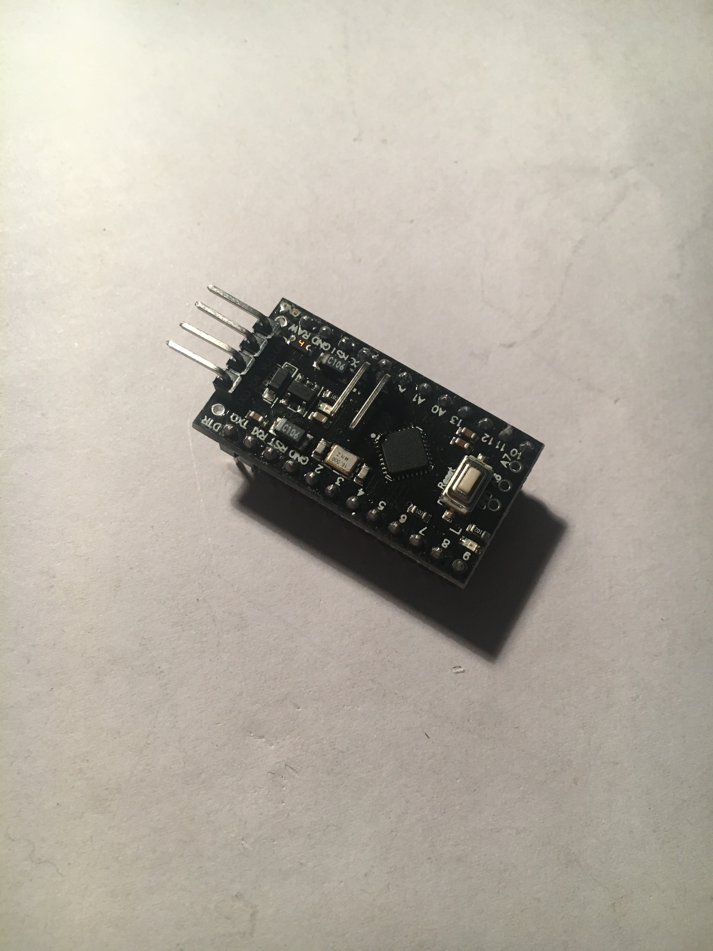
Documentatie/Dossier/Fotos/IMG_4137.JPG
