CodeStix/Home-Control-GIP/Documentatie/Dossier/Fotos/IMG_4138.JPG

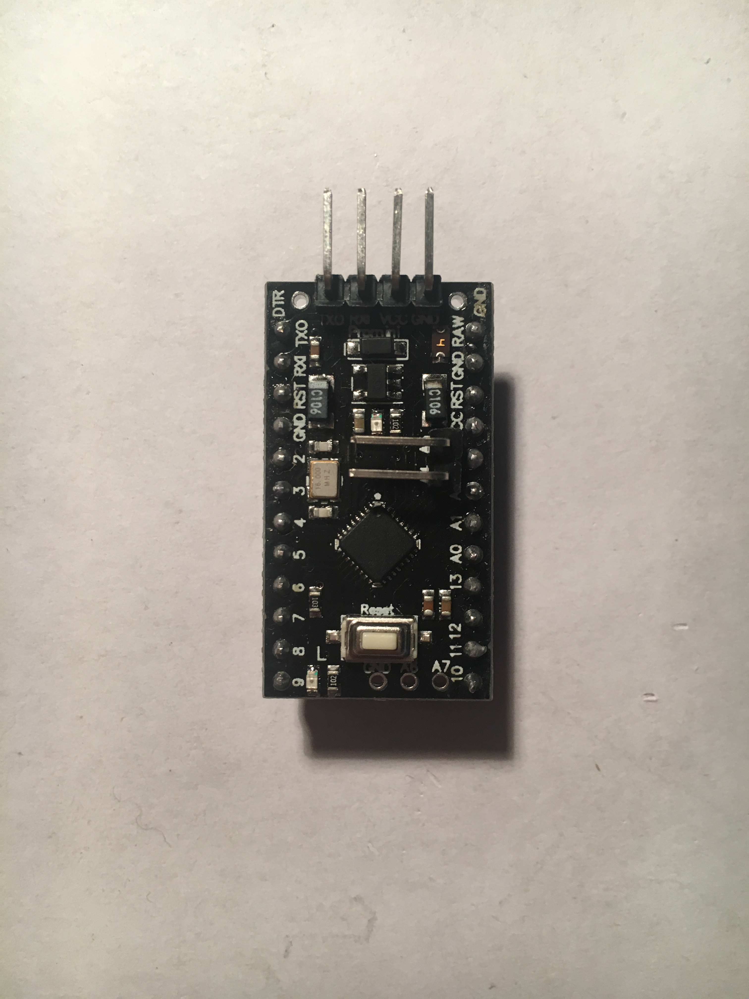
Documentatie/Dossier/Fotos/IMG_4138.JPG
