CodeStix/Home-Control-GIP/Documentatie/Dossier/Fotos/IMG_4139.JPG

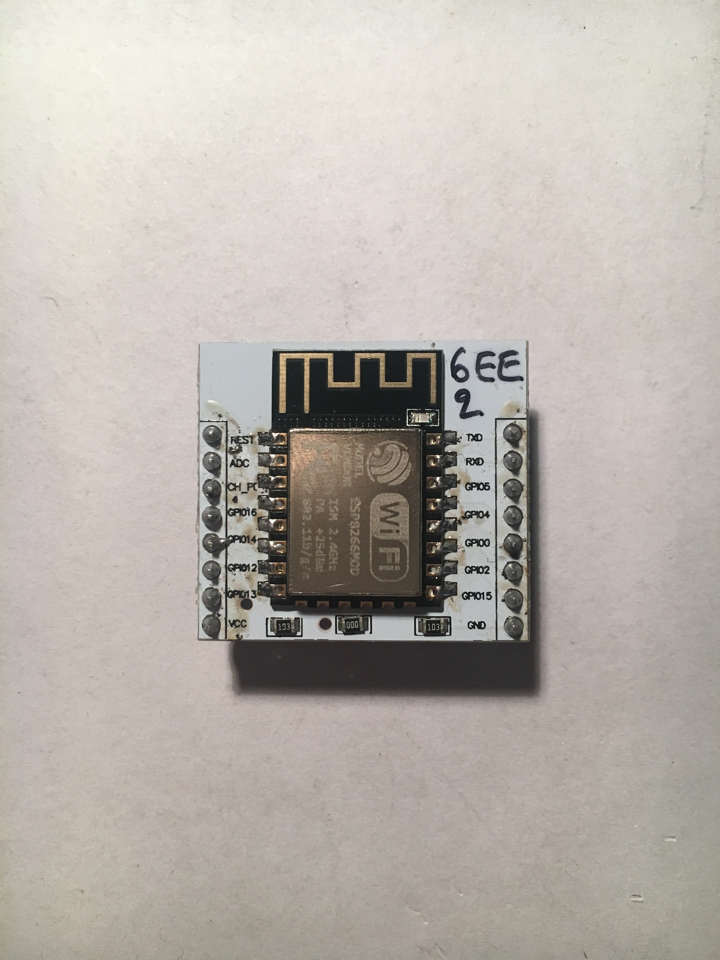
Documentatie/Dossier/Fotos/IMG_4139.JPG
