CodeStix/Home-Control-GIP/Documentatie/Dossier/Fotos/IMG_4140.JPG

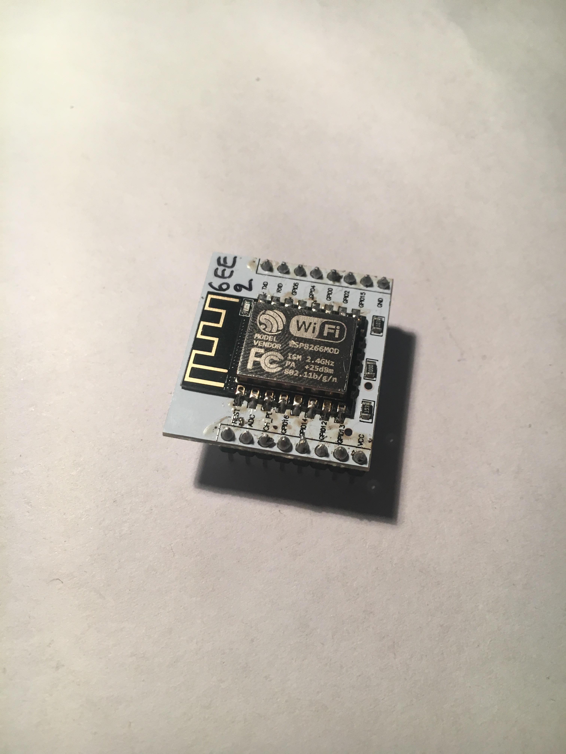
Documentatie/Dossier/Fotos/IMG_4140.JPG
