CodeStix/Home-Control-GIP/Documentatie/Dossier/Fotos/IMG_4446.JPG

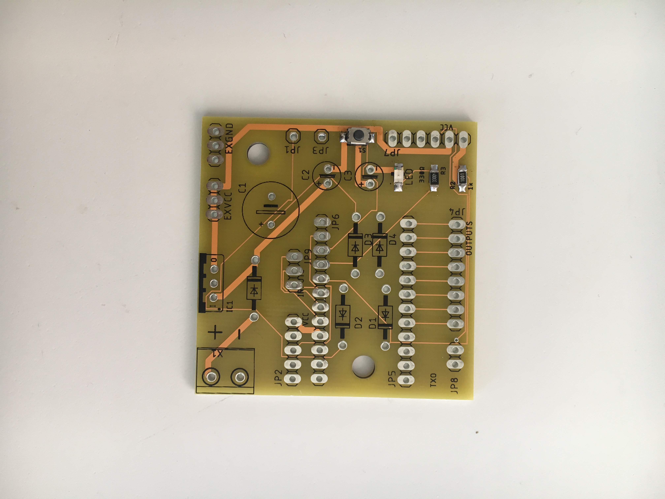
Documentatie/Dossier/Fotos/IMG_4446.JPG
