CodeStix/Home-Control-GIP/Documentatie/Dossier/Fotos/IMG_4447.JPG

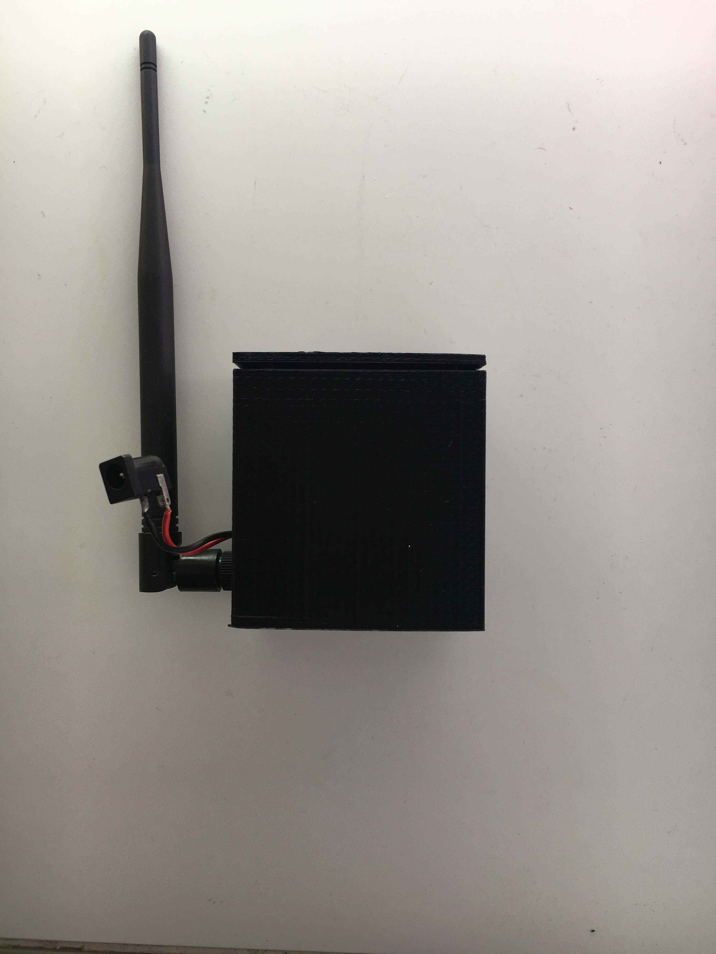
Documentatie/Dossier/Fotos/IMG_4447.JPG
