CodeStix/Home-Control-GIP/Documentatie/Dossier/Fotos/IMG_4448.JPG

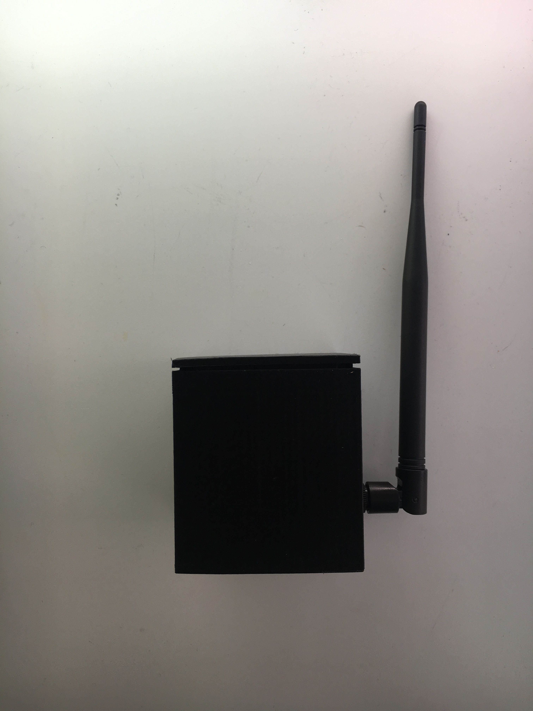
Documentatie/Dossier/Fotos/IMG_4448.JPG
