CodeStix/Home-Control-GIP/Documentatie/Dossier/Fotos/IMG_4449.JPG

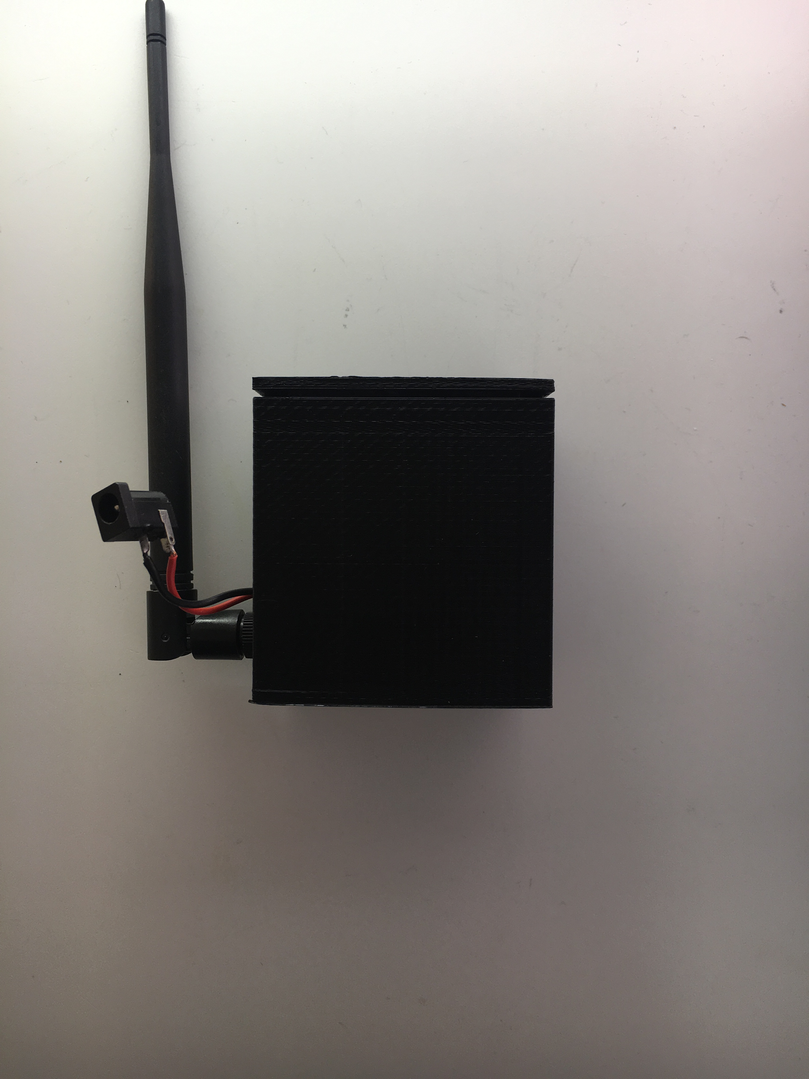
Documentatie/Dossier/Fotos/IMG_4449.JPG
