CodeStix/Home-Control-GIP/Documentatie/Dossier/Fotos/IMG_E4448.JPG

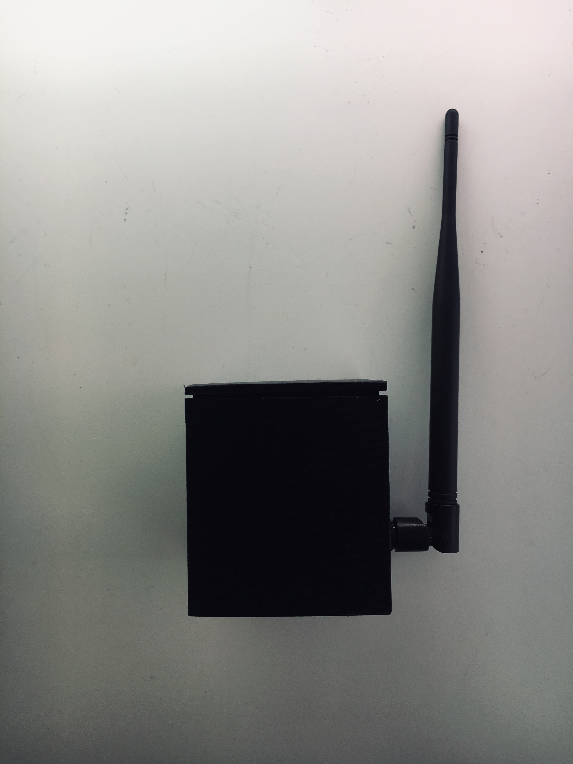
Documentatie/Dossier/Fotos/IMG_E4448.JPG
