CodeStix/Home-Control-GIP/Documentatie/Dossier/Fotos/master render.png

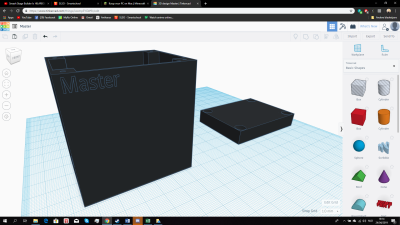
Documentatie/Dossier/Fotos/master render.png
