CodeStix/Home-Control-GIP/Documentatie/Dossier/Fotos/slave render.png

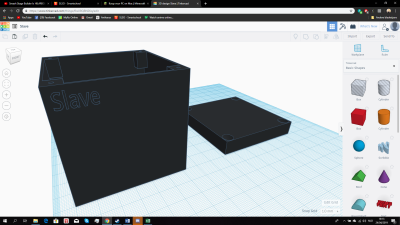
Documentatie/Dossier/Fotos/slave render.png
