CodeStix/Home-Control-GIP/Documentatie/Dossier/Fotos/stroommetingen.png

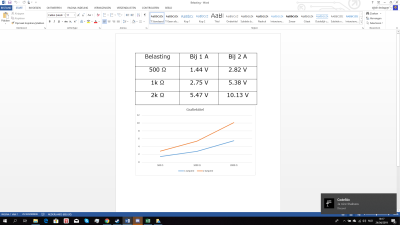
Documentatie/Dossier/Fotos/stroommetingen.png
