CodeStix/Home-Control-GIP/Documentatie/Dossier/HC12-2.PNG

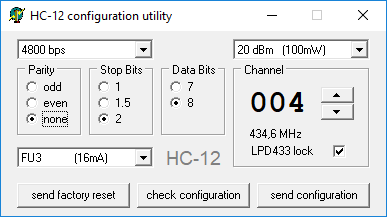
Documentatie/Dossier/HC12-2.PNG
