CodeStix/Home-Control-GIP/Documentatie/Dossier/HC12-3.PNG

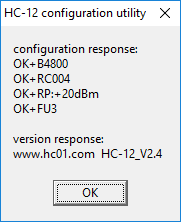
Documentatie/Dossier/HC12-3.PNG
