CodeStix/Home-Control-GIP/Documentatie/Dossier/model master.png

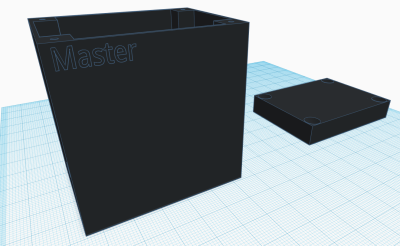
Documentatie/Dossier/model master.png
