CodeStix/Home-Control-GIP/Documentatie/Dossier/model slave.png

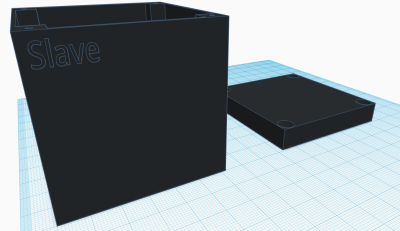
Documentatie/Dossier/model slave.png
