CodeStix/Home-Control-GIP/Documentatie/Dossier/thunkable prop code.png

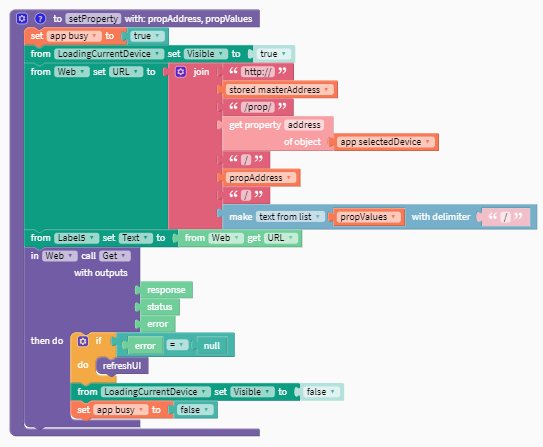
Documentatie/Dossier/thunkable prop code.png
