CodeStix/Home-Control-GIP/Documentatie/Dossier/print screens.docx

Master doos

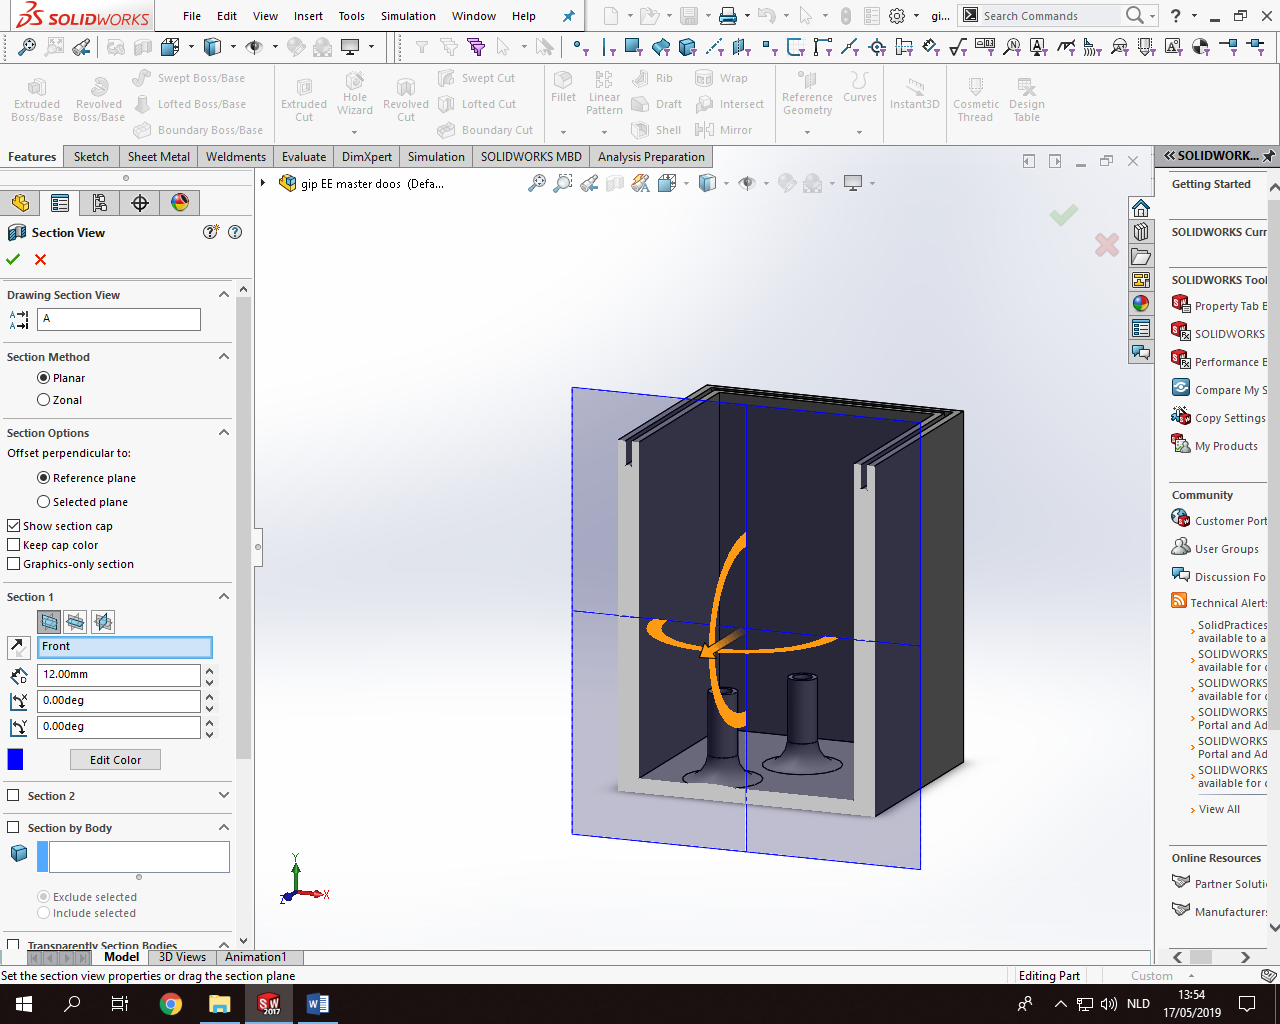
[picture p153: figure]
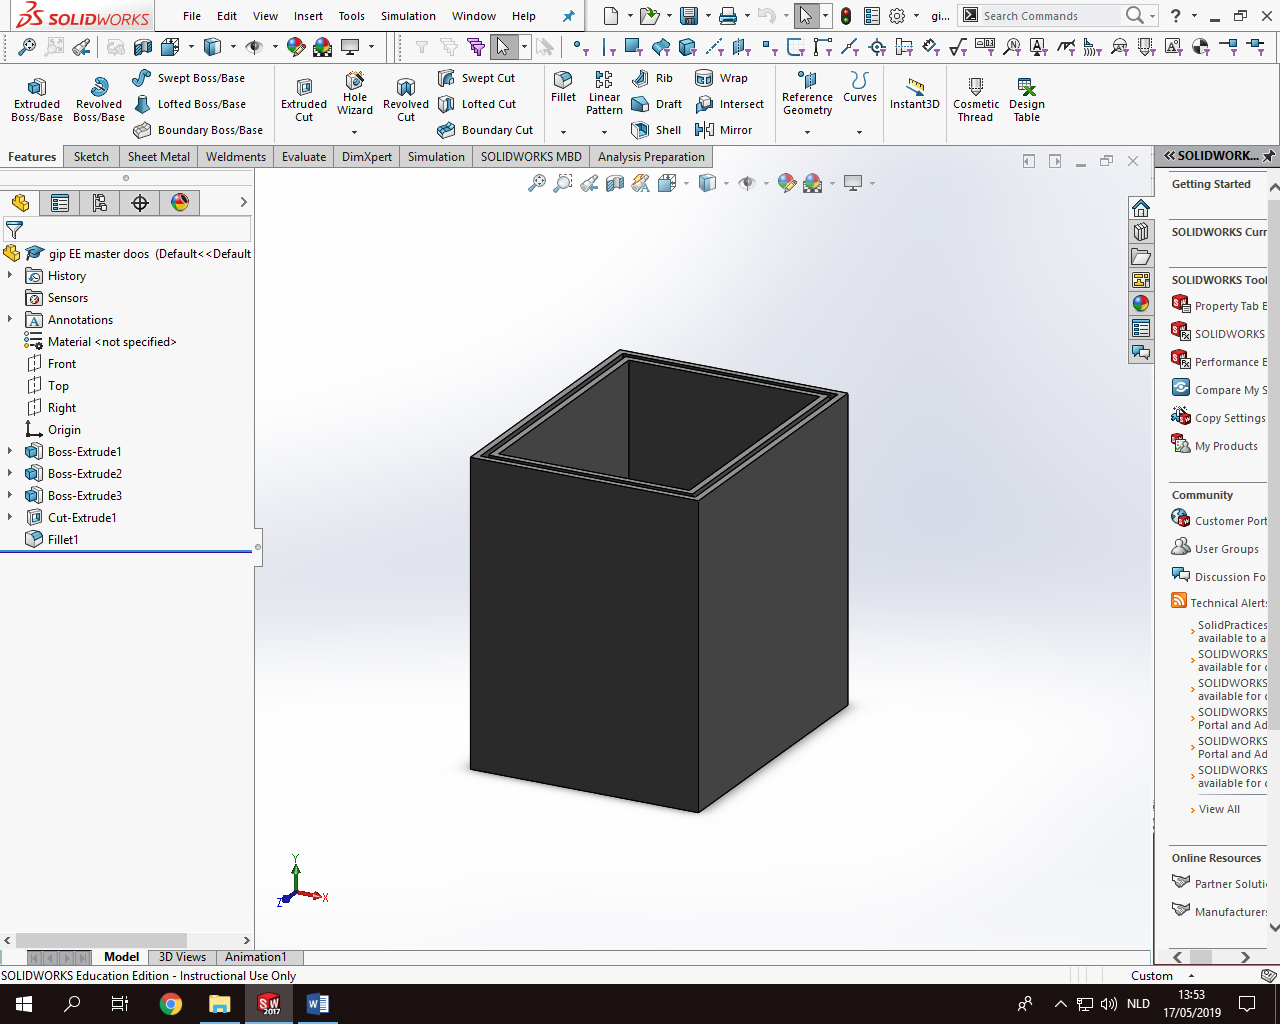
[picture p154: figure]

Deksel master

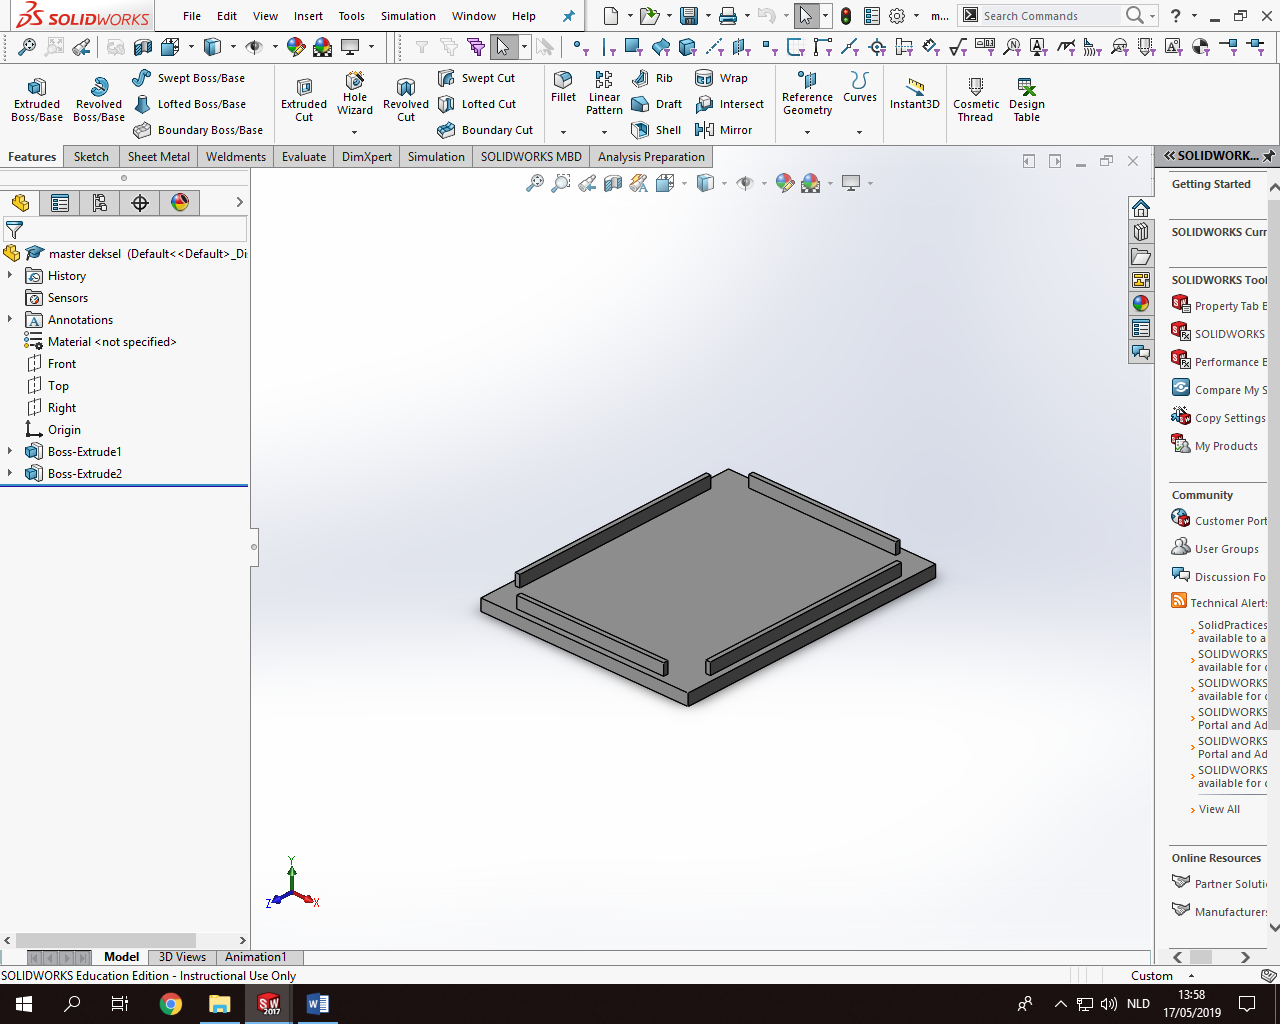
[picture p155: figure]

Doos slave

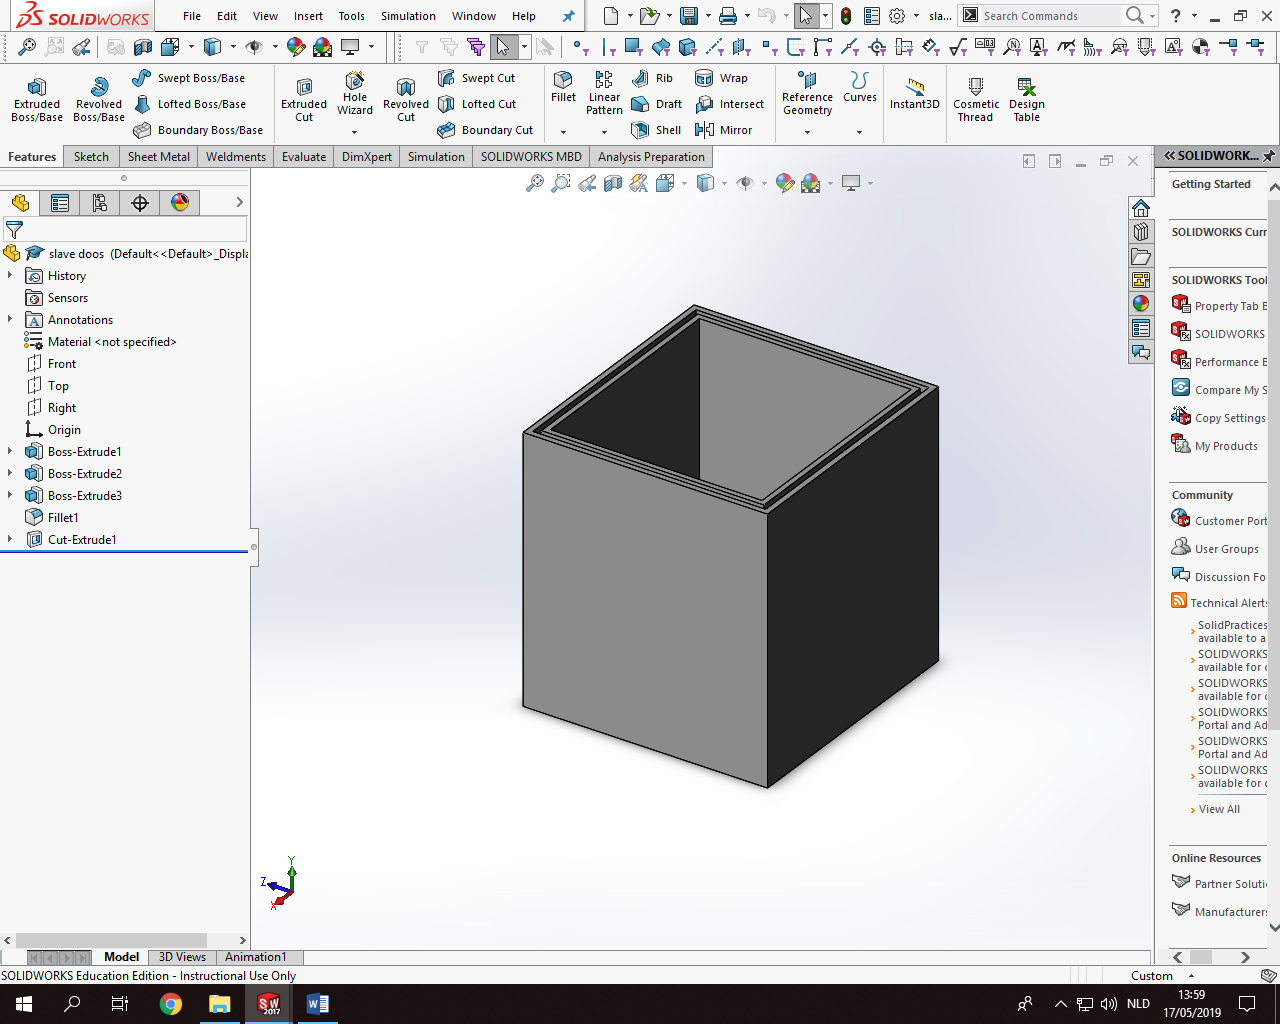
[picture p156: figure]
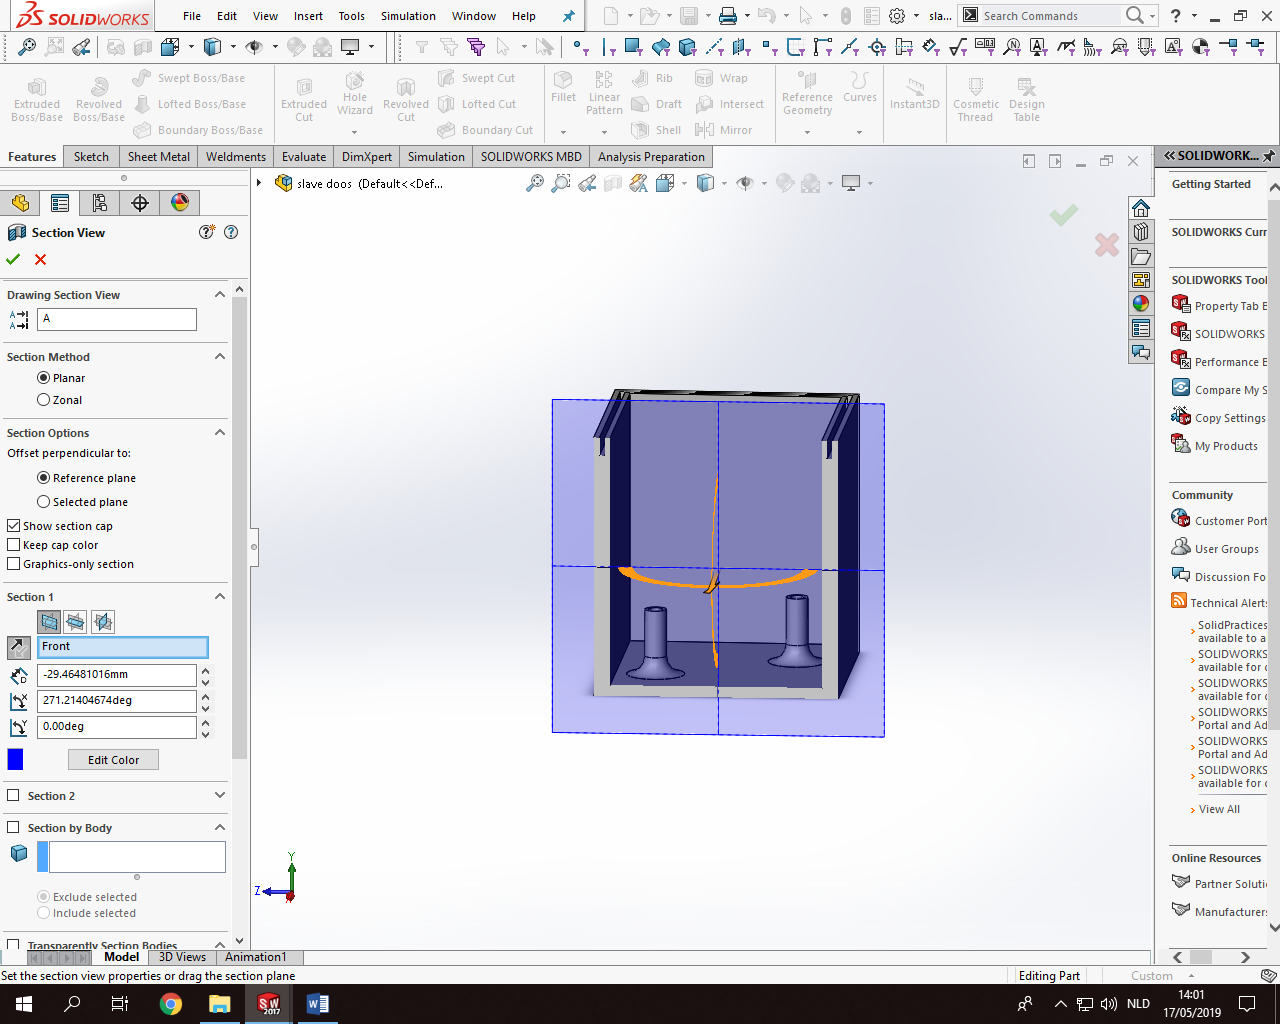
[picture p157: figure]
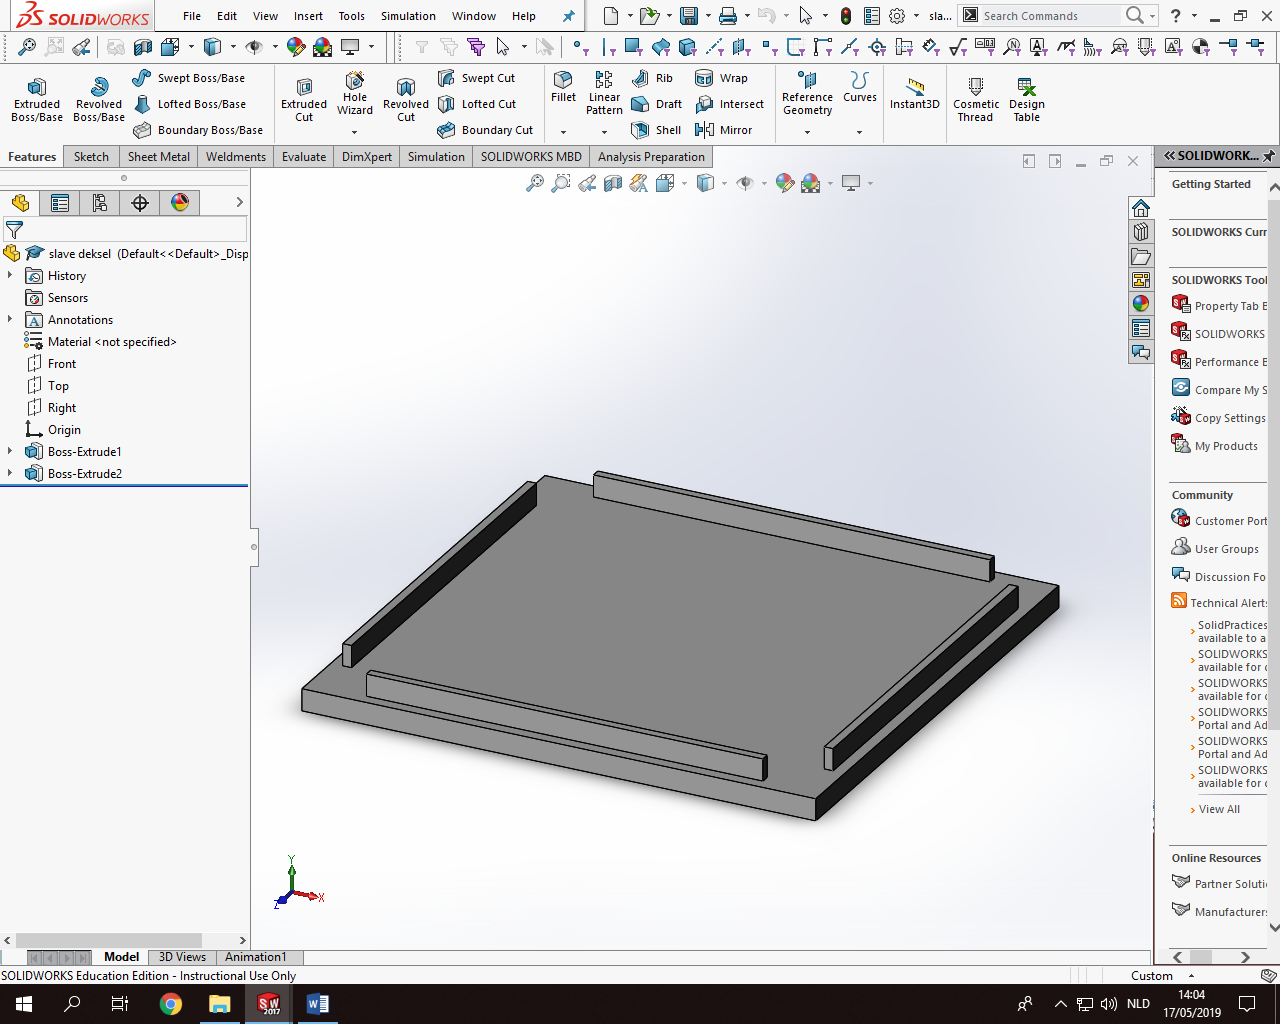
[picture p158: figure]
