CodeStix/Home-Control-GIP/Schemas/berichten1993387/Master PCB.pdf

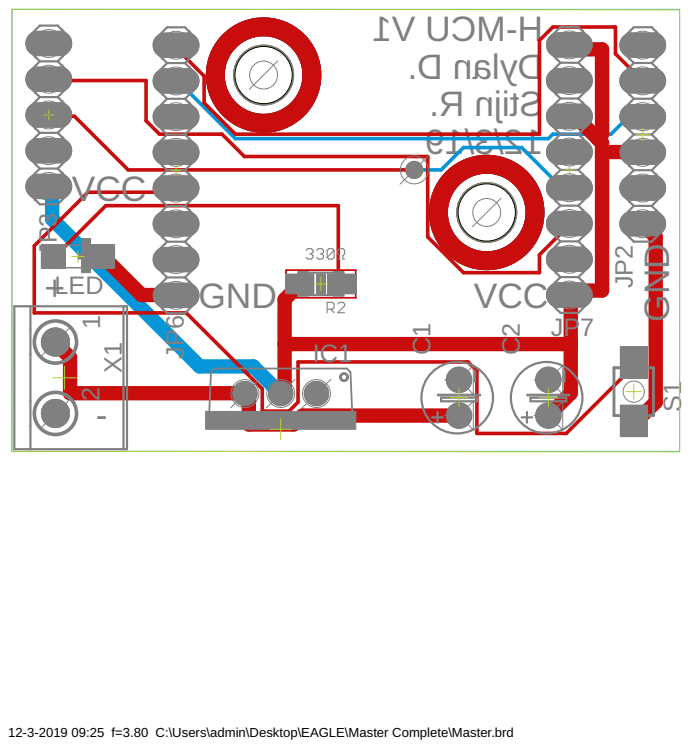
[picture p159: page 1]

12-3-2019 09:25 f=3.80 C:\Users\admin\Desktop\EAGLE\Master Complete\Master.brd
