CodeStix/Home-Control-GIP/Schemas/berichten1993387/Master Schema.pdf

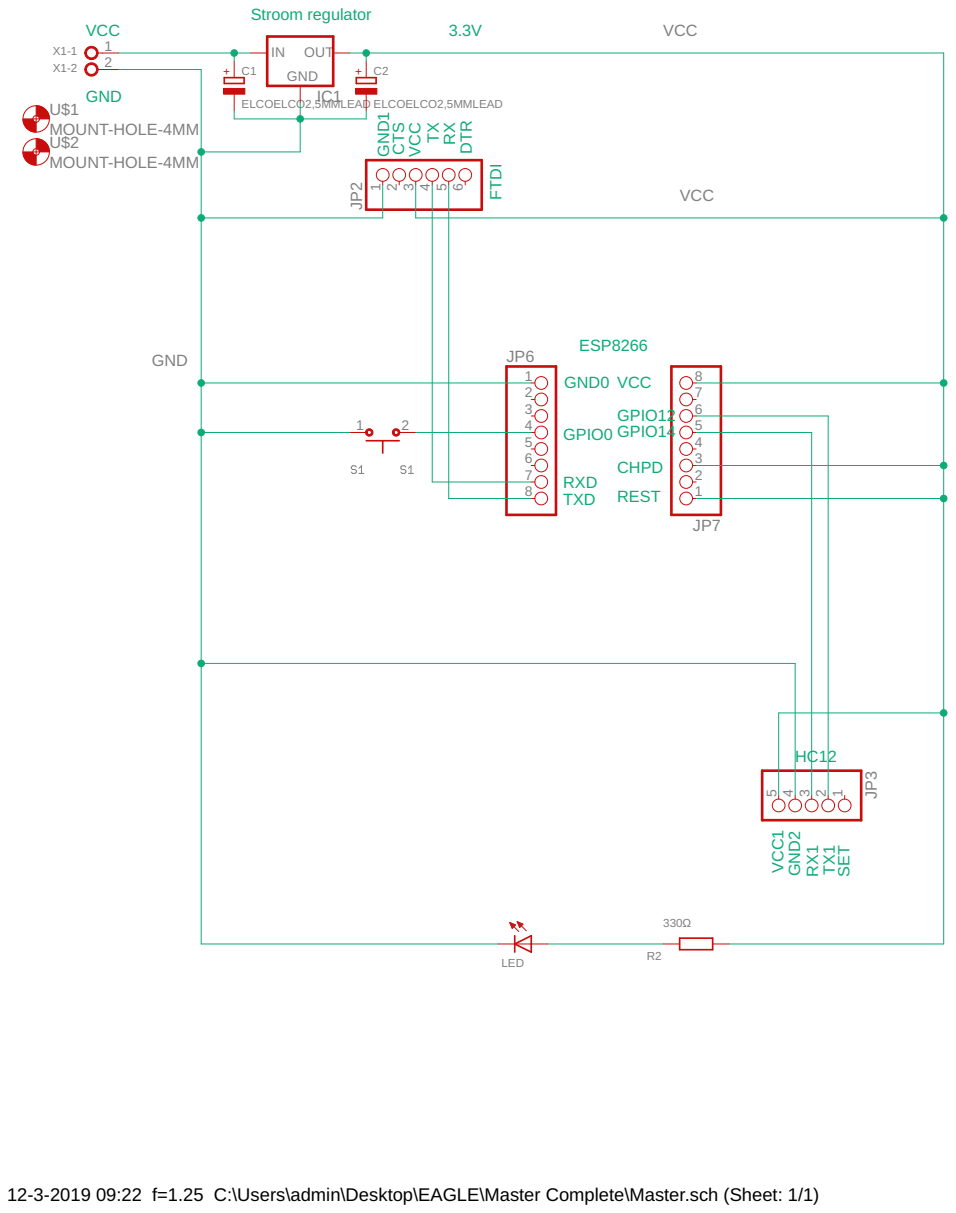
[picture p160: page 1]

12-3-2019 09:22 f=1.25 C:\Users\admin\Desktop\EAGLE\Master Complete\Master.sch (Sheet: 1/1)
