CodeStix/Home-Control-GIP/Schemas/berichten1993387/Slave PCB.pdf

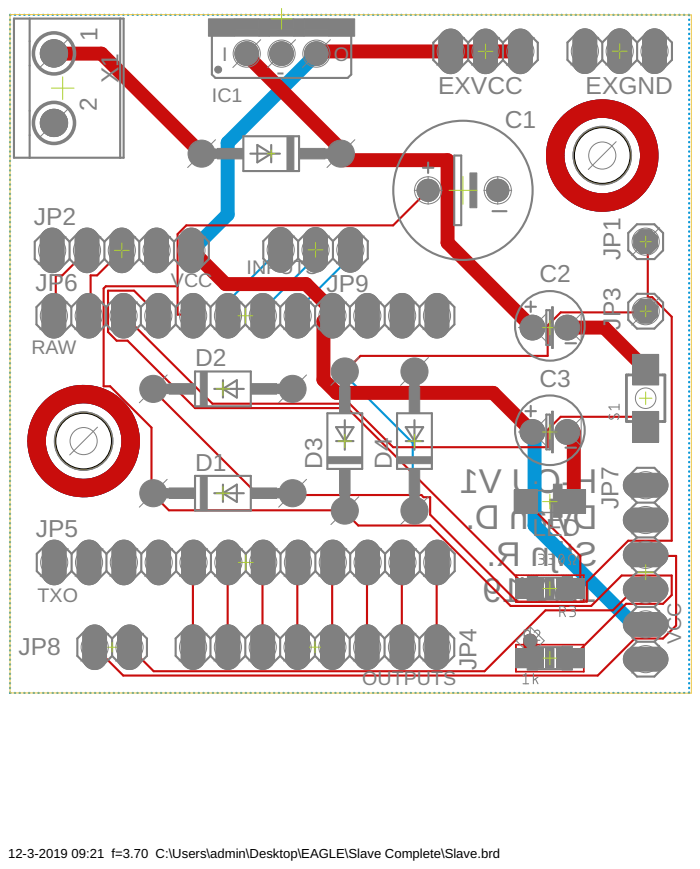
[picture p161: page 1]

12-3-2019 09:21 f=3.70 C:\Users\admin\Desktop\EAGLE\Slave Complete\Slave.brd
