CodeStix/Home-Control-GIP/Schemas/berichten1993387/Slave Schema.pdf

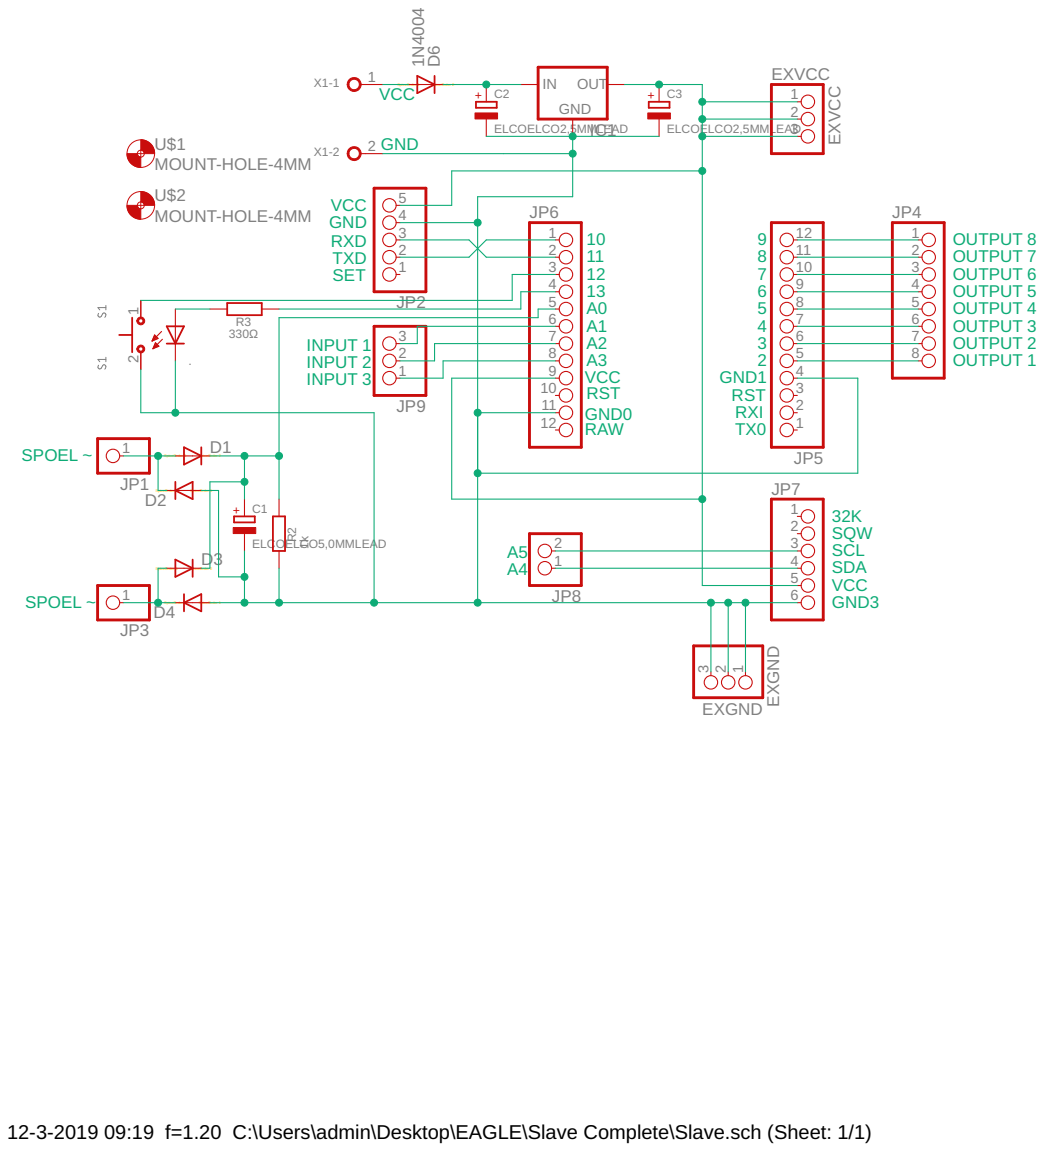
[picture p162: page 1]

12-3-2019 09:19 f=1.20 C:\Users\admin\Desktop\EAGLE\Slave Complete\Slave.sch (Sheet: 1/1)
