CodeStix/Home-Control-GIP/Schemas/Master.pdf

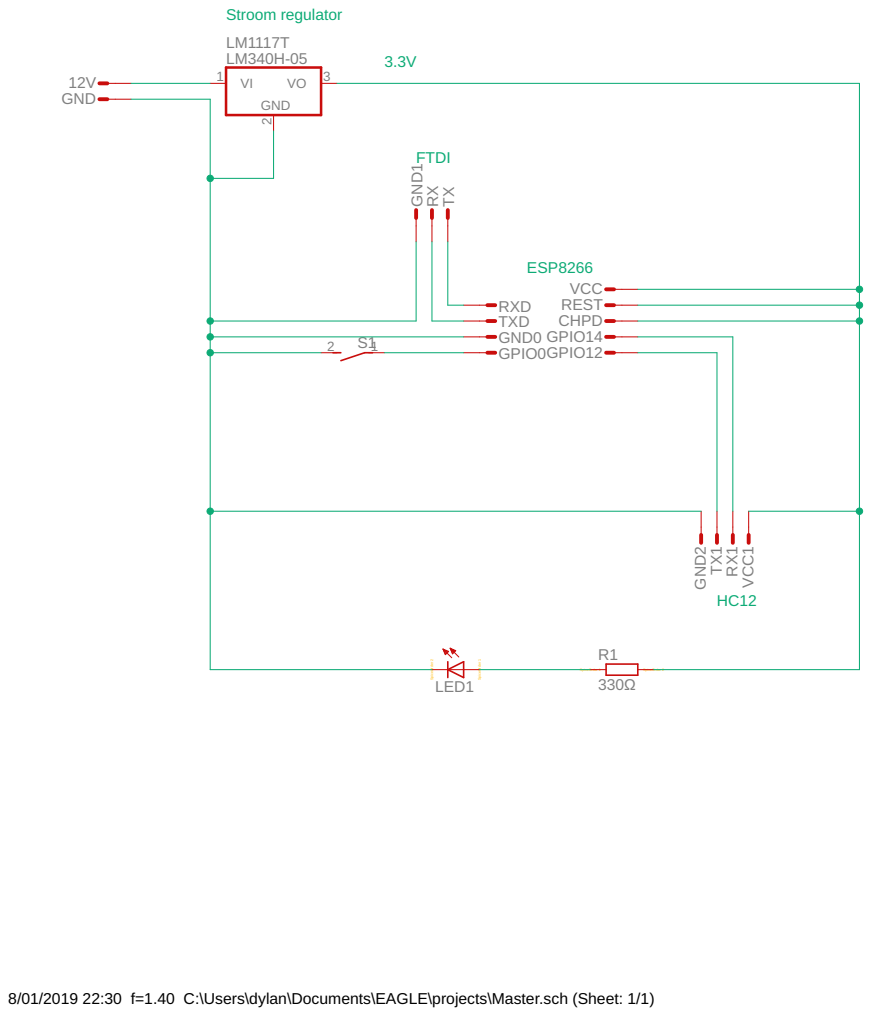
[picture p163: page 1]

8/01/2019 22:30 f=1.40 C:\Users\dylan\Documents\EAGLE\projects\Master.sch (Sheet: 1/1)
