CodeStix/Home-Control-GIP/Schemas/Slave.pdf

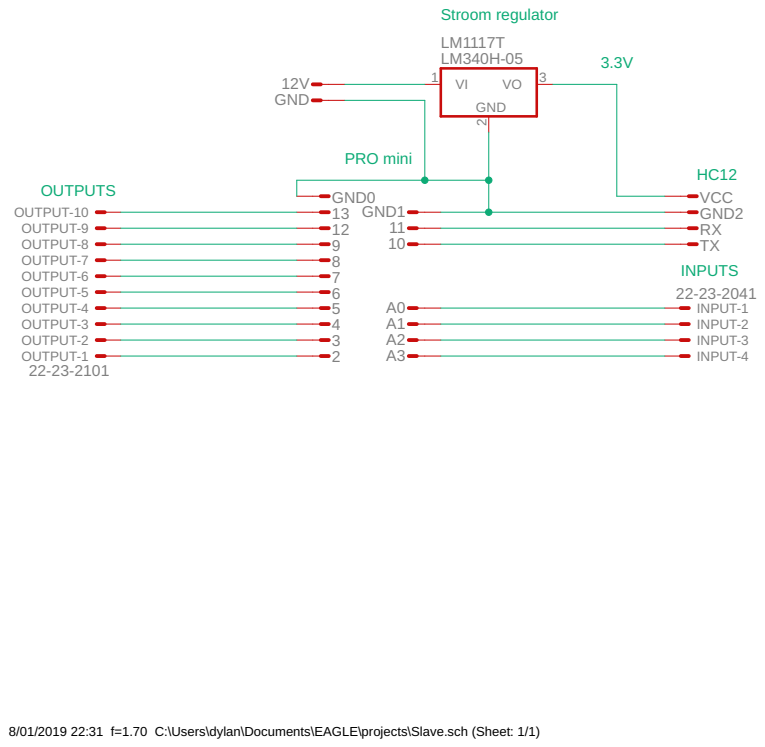
[picture p164: page 1]

8/01/2019 22:31 f=1.70 C:\Users\dylan\Documents\EAGLE\projects\Slave.sch (Sheet: 1/1)
