CodeStix/Home-Control-GIP/Documentatie/Dossier/Flowchart HCP_CU/Flowchart HCP_CU.pdf

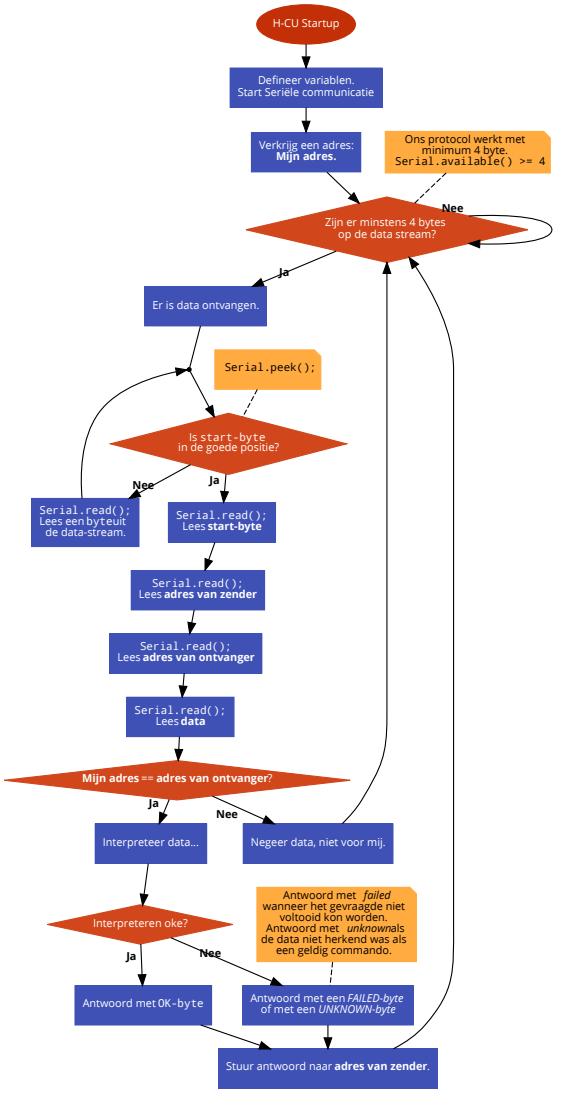
[picture p165: page 1]
H-CU Startup; Nee; Serial.read(); Lees data; Interpreteer data...; Interpreteren oke?; Serial.peek();

Defineer variablen.
Start Seriële communicatie

Ons protocol werkt met
minimum 4 byte.
Serial.available() >= 4

Verkrijg een adres:
Mijn adres.

Zijn er minstens 4 bytes
op de data stream?

Er is data ontvangen.

Is start-byte
in de goede positie?

Serial.read();
Lees een byteuit
de data-stream.

Lees start-byte

Lees adres van zender

Lees adres van ontvanger

Mijn adres == adres van ontvanger?

Negeer data, niet voor mij.

Antwoord met failed
wanneer het gevraagde niet
voltooid kon worden.
Antwoord met unknownals
de data niet herkend was als
een geldig commando.

Antwoord met een FAILED-byte
of met een UNKNOWN-byte

Antwoord met OK-byte

Stuur antwoord naar adres van zender.
