CodeStix/Home-Control-GIP/Documentatie/Dossier/Flowchart HCP_MCU/Flowchart HCP_MCU.pdf

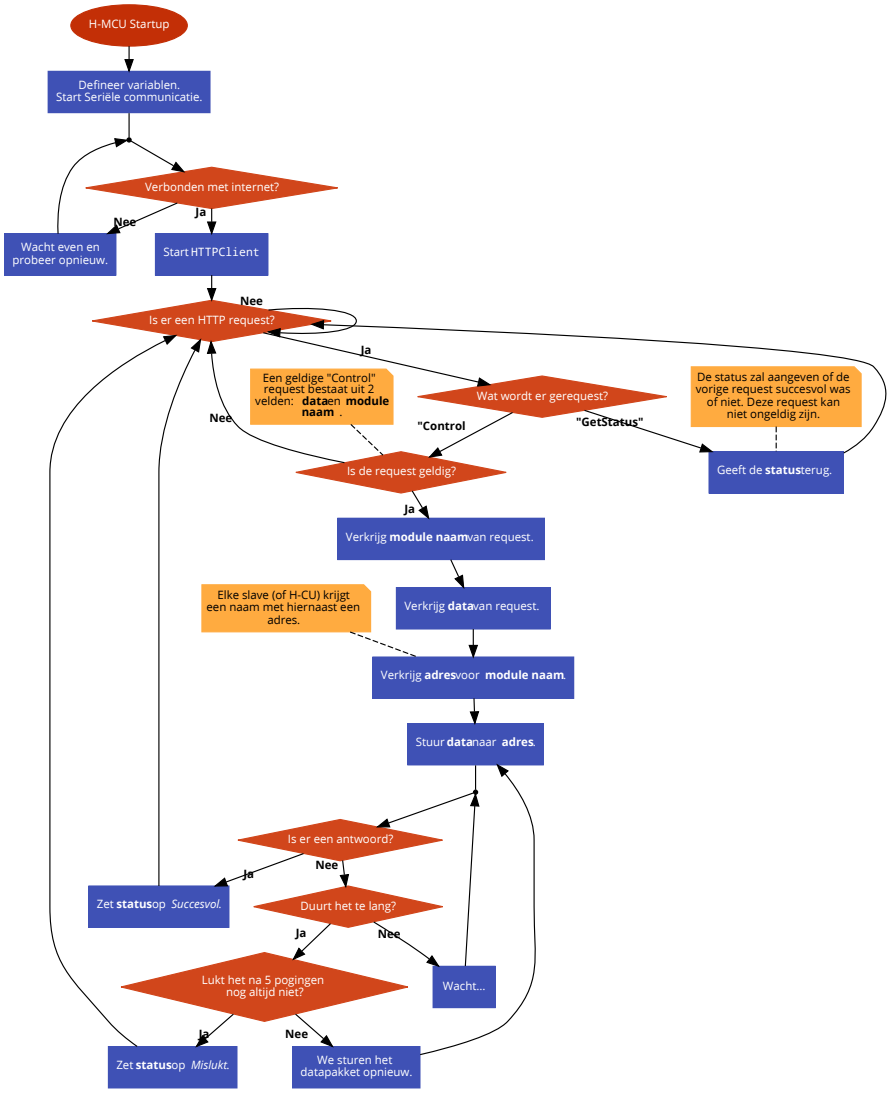
[picture p166: page 1]
H-MCU Startup; Nee; Start HTTPClient; "Control; "GetStatus"; Wacht...; adres.

Defineer variablen.
Start Seriële communicatie.

Verbonden met internet?

Wacht even en
probeer opnieuw.

Is er een HTTP request?

Een geldige "Control"
request bestaat uit 2
velden: dataen module
naam .

De status zal aangeven of de
vorige request succesvol was
of niet. Deze request kan
niet ongeldig zijn.

Wat wordt er gerequest?

Geeft de statusterug.

Is de request geldig?

Verkrijg module naamvan request.

Elke slave (of H-CU) krijgt
een naam met hiernaast een

Verkrijg datavan request.

Verkrijg adresvoor module naam.

Stuur datanaar adres.

Is er een antwoord?
Nee

Zet statusop Succesvol.

Duurt het te lang?

Lukt het na 5 pogingen
nog altijd niet?

We sturen het
datapakket opnieuw.

Zet statusop Mislukt.
