CodeStix/Home-Control-GIP/Schemas/berichten1993387/Slave.brd

## EAGLE design Schemas/berichten1993387/Slave.brd (2019-04-24)

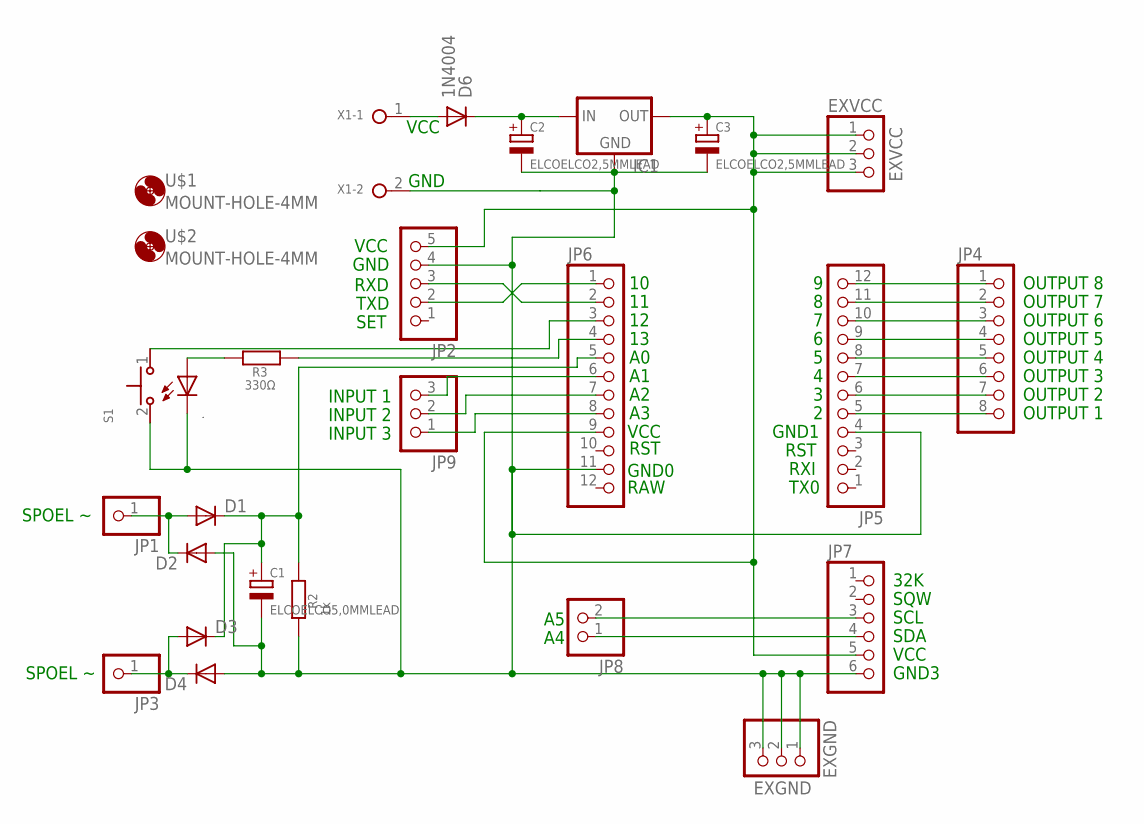
[picture p167: schematic Slave.sch]

Parts:
.: LED; CHIPLED_1206
C1: ELCOELCO5,0MMLEAD; ELCO5,0MMLEAD
C2, C3: ELCOELCO2,5MMLEAD; ELCO-2.5MMLEAD
D1, D2, D3, D4, D6: 1N4004; DO41-10
EXGND: PINHD-1X3; 1X03
EXVCC: PINHD-1X3; 1X03
IC1: 78XXS
JP1, JP3: PINHD-1X1; 1X01
JP2: PINHD-1X5; 1X05
JP4: PINHD-1X8; 1X08
JP5, JP6: PINHD-1X12; 1X12
JP7: PINHD-1X6; 1X06
JP8: PINHD-1X2; 1X02
JP9: PINHD-1X3; 1X03
R2: 1k; R1206W
R3: 330Ω; R1206W
S1: MICROSWITCH-B3U-1000P
U$1, U$2: MOUNT-HOLE-4MM; 4,0
X1: TERMINAL-5MM-2POLE; W237-132

Connections:
GND: ..C, C1.-, C2.-, C3.-, D2.A, D4.A, EXGND.1, EXGND.2, EXGND.3, IC1.GND, JP2.4, JP5.4, JP6.11, JP7.6, R2.1, S1.2, X1.2
unnamed: JP7.4, JP8.1
unnamed: JP7.3, JP8.2
unnamed: JP4.1, JP5.12
unnamed: JP4.2, JP5.11
unnamed: JP4.3, JP5.10
unnamed: JP4.4, JP5.9
unnamed: JP4.5, JP5.8
unnamed: JP4.6, JP5.7
unnamed: JP4.7, JP5.6
unnamed: JP4.8, JP5.5
unnamed: D1.A, D2.C, JP1.1
unnamed: C1.+, D1.C, D3.C, JP6.5, R2.2
unnamed: JP6.8, JP9.1
unnamed: D3.A, D4.C, JP3.1
unnamed: JP6.7, JP9.2
unnamed: JP6.6, JP9.3
unnamed: JP2.2, JP6.1
unnamed: JP6.4, R3.2
unnamed: JP2.3, JP6.2
unnamed: ..A, R3.1
unnamed: JP6.3, S1.1
VCC0: D6.A, X1.1
VCC1: C2.+, D6.C, IC1.IN
VCC2: C3.+, EXVCC.1, EXVCC.2, EXVCC.3, IC1.OUT, JP2.5, JP6.9, JP7.5

Notes on the sheet:
RST
RXI
TX0
VCC
RAW
GND0
GND1
OUTPUT 1
OUTPUT 2
OUTPUT 3
OUTPUT 4
OUTPUT 5
OUTPUT 6
OUTPUT 7
OUTPUT 8
GND3
SDA
SCL
SQW
32K
SET
TXD
RXD
GND
INPUT 1
INPUT 2
INPUT 3
SPOEL ~

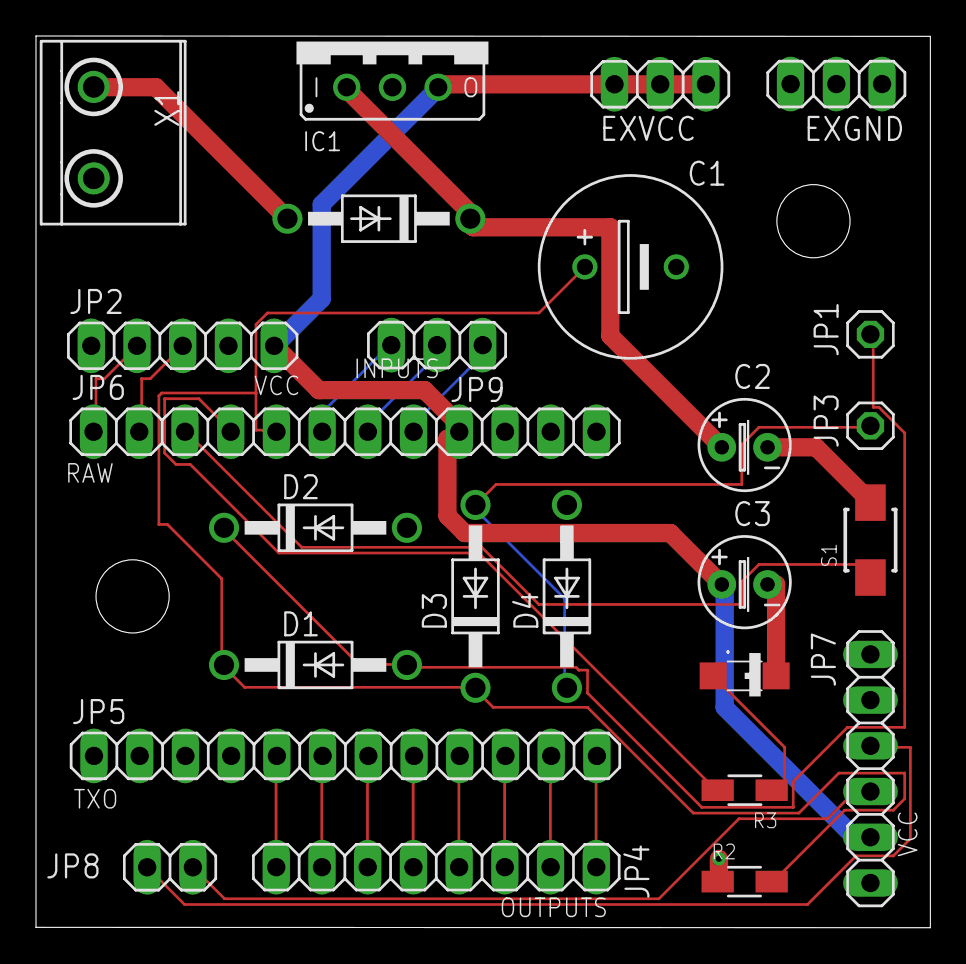
[picture p168: board Slave.brd from above]

Board: 2 copper layers, 49.7 x 49.5 mm, 27 parts (0 on the bottom side), 25 nets.
