CodeStix/Home-Control-GIP/Schemas/berichten1993387/Master.brd

## EAGLE design Schemas/berichten1993387/Master.brd (2019-04-24)

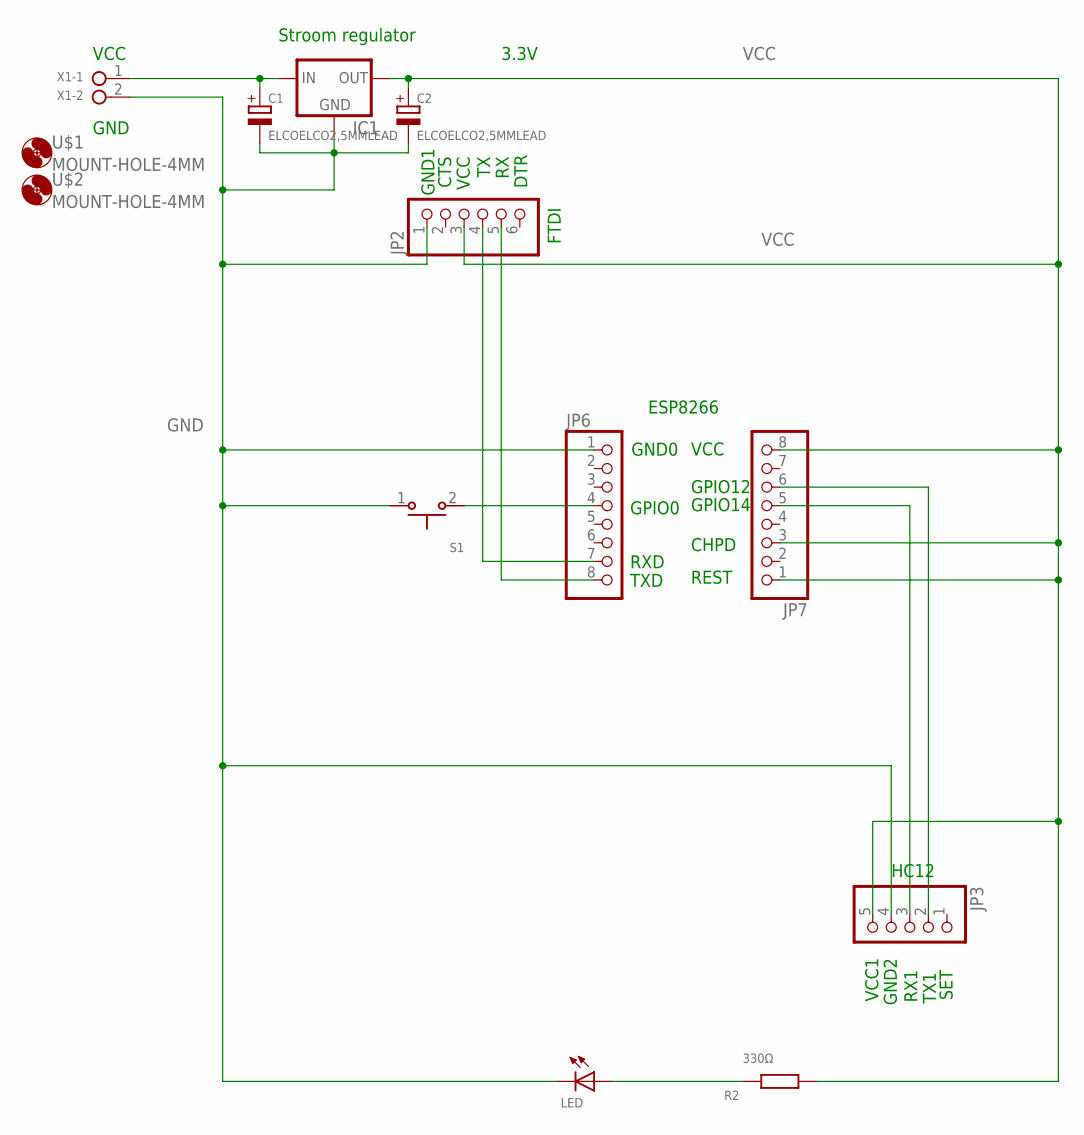
[picture p169: schematic Master.sch]

Parts:
C1, C2: ELCOELCO2,5MMLEAD; ELCO-2.5MMLEAD
IC1: LM1117-TO220; TO220V
JP2: PINHD-1X6; 1X06
JP3: PINHD-1X5; 1X05
JP6, JP7: PINHD-1X8; 1X08
LED: LED-SMD1206; CHIPLED_1206
R2: 330Ω; R1206W
S1: MICROSWITCH-B3U-1000P
U$1, U$2: MOUNT-HOLE-4MM; 4,0
X1: TERMINAL-5MM-2POLE; W237-132

Connections:
GND: C1.-, C2.-, IC1.1 (GND), JP2.1, JP3.4, JP6.1, LED.C, S1.1, X1.2
unnamed: LED.A, R2.1
unnamed: JP3.2, JP7.6
unnamed: JP3.3, JP7.5
unnamed: JP6.4, S1.2
unnamed: JP2.5, JP6.8
unnamed: JP2.4, JP6.7
VCC: C2.+, IC1.2 (OUT), JP2.3, JP3.5, JP7.1, JP7.3, JP7.8, R2.2
VIN: C1.+, IC1.3 (IN), X1.1

Notes on the sheet:
3.3V
HC12
FTDI
ESP8266
Stroom regulator
RXD
TXD
GND0
GPIO0
GPIO12
GPIO14
CHPD
REST
VCC
GND
GND2
TX1
RX1
VCC1
SET
DTR
CTS
GND1

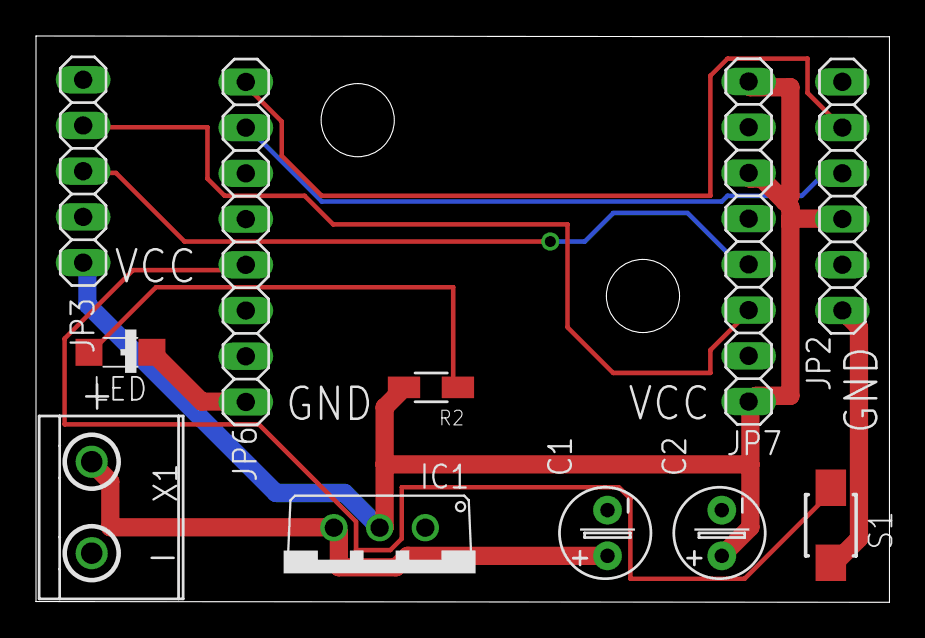
[picture p170: board Master.brd from above]

Board: 2 copper layers, 47.4 x 31.5 mm, 13 parts (0 on the bottom side), 9 nets.
