CodeStix/Home-Control-GIP/(commit log)

2018-11-06 led via radio
2019-01-15 renamed folder
    [Stroommeting handmatig.csv]
2019-01-15 renamed stuff
    [Stroommeting handmatig.csv]
2019-01-15 verplaatsingen en opruiming
    [Stroommeting handmatig.csv]
2019-01-15 dir voor schema
    [Master.sch, Slave.sch]
2019-01-15 flowcharts toegevoegd
2019-04-20 Request system + binding and unbinding
    [HCP_CU_v4.ino, HCP_MCU_v4.ino, Request.cpp, Request.h]
2019-04-20 Device class
2019-04-20 Device saving system v1
2019-04-20 Device saving system v2 + bind/unbind
2019-04-24 Verplaatsen van stuff
    [LOGBOEK.csv]
2019-04-24 Documentatie v3
    [Master.brd, Master.sch, Slave.brd, Slave.sch]
2019-05-20 App add and remove and documentation
    [app_bar_main.xml]
2019-05-24 Fix http request problem
    [HCP_CU_v4.ino, HCP_MCU_v4.ino]
2019-05-27 Documentatie en live data fix
    [Device.cpp, HCP_CU_v4.ino, HCP_MCU_v4.ino, Packet.cpp, Request.cpp]
2019-06-03 Byte to temperature
